szohar/TrueLocation_lay/TruelocationRev3.0/TruelocationRev3.0-by-mpn.xlsx

Reference | Value | Datasheet | Footprint | Description | Qty | MANUFACTURER | MANUFACTURER P/N | MFG_PN | DNP | CHANGED | STATUS | ALT. MFR. | ALT MFR. PART | ALT. REPLACEMENT COMMENT
ANT1 | SR4W035 | https://www.antenova.com/wp-content/uploads/2019/05/Serica-SR4W035-PS-1.1.pdf | Library:IC_ANT_W6.1L4.1H0.5_6PIN | RF ANT 2.4GHZ CHIP SOLDER SMD | 1 | ANTENOVA | SR4W035
C1,C8,C19,C20,C28,C30,C31,C34,C36,C38,C40,C41,C42,C45,C47,C48,C51,C52,C54,C56,C57,C58,C62,C63,C65,C67,C72,C74,C78,C79,C80,C81,C82,C83,C86,C87,C90,C91,C93,C94,C95,C96,C99,C104,C118,C119,C121,C124,C127,C132,C136,C138,C147,C153,C158,C167,C171,C173,C174,C177,C178,C180,C182,C185,C188,C209 | 0.1uF | https://mm.digikey.com/Volume0/opasdata/d220001/medias/docus/2715/CL05B104KO5NFNC_Spec.pdf | -- mixed values -- | CAP CER 0.1UF 16V X7R 0402 | 66 | SAMSUNG | CL05B104KO5NFNC |  |  | -- mixed values --
C2,C14 | 15pF | https://search.kemet.com/download/datasheet/C0402C150J4GAC7867 | Library:CAP_CHIP_0402_W24L44H24_RFL | CAP CER 15PF 16V C0G/NP0 0402 | 2 | KEMET | C0402C150J4GACTU
C3,C4,C25,C27,C32,C100,C101,C103,C105,C112,C114,C179,C186,C187 | 2.2uF | https://mm.digikey.com/Volume0/opasdata/d220001/medias/docus/387/LMK105BJ225MV-F_SS.pdf | Library:CAP_CHIP_0402_W24L44H24_RFL | CAP CER 2.2UF 10V X5R 0402 | 14 | TAIYO YUDEN | LMK105BJ225MV-F |  |  | -- mixed values --
C5 | 0.6pF | https://www.johansondielectrics.com/search/pdf/?s=%22QSCF500Q0R6A1GV001T%22 | Library:CAP_CHIP_0402_W24L44H24_RFL | CAP CER 0.6PF 50V C0G/NP0 0402 | 1 | JOHANSON TECHNOLOGY | QSCF500Q0R6A1GV001T |  |  | 1
C6,C11,C12,C15,C16,C22,C23,C24,C43,C44,C53,C59,C60,C68,C69,C70,C76,C77,C84,C85,C97,C98,C172 | 22pF | https://search.murata.co.jp/Ceramy/image/img/A01X/G101/ENG/GCM1555C1HR50BA16-01A.pdf | Library:CAP_CHIP_0402_W24L44H24_RFL | CAP CER 22PF 50V C0G/NP0 0402 | 23 | MURATA ELECTRONICS | GCM1555C1H220JA16D |  |  | -- mixed values --
C7,C13,C106 | NI | https://search.kemet.com/download/datasheet/C0603C220J5GAC7867 | Library:CAP_CHIP_0402_W24L44H24_RFL | CAP CER 22PF 50V C0G/NP0 0603 | 3 | AVX | C0603C220J5GACTU |  | DNP
C9,C18,C141,C142 | 10uF | https://search.murata.co.jp/Ceramy/image/img/A01X/G101/ENG/GRM188R61A106KE69-01.pdf | -- mixed values -- | CAP CER 10UF 10V X5R 0603 | 4 | MURATA ELECTRONICS | GRM188R61A106KE69J |  |  | 1 | NON STOCK | KYOCERA | 0603ZD106KAT2A | SUGGESTED DIRECT REPLACEMENT
C10 | 1.2pF | https://search.murata.co.jp/Ceramy/image/img/A01X/G101/ENG/GJM1555C1H1R2WB01-01.pdf | Library:CAP_CHIP_0402_W24L44H24_RFL | CAP CER 1.2PF 50V C0G/NP0 0402 | 1 | MURATA ELECTRONICS | GJM1555C1H1R2WB01D
C17 | 1.8nF | https://search.murata.co.jp/Ceramy/image/img/A01X/G101/ENG/GRM155R71H182JA01-01.pdf | Library:CAP_CHIP_0402_W24L44H24_RFL | CAP CER 1800PF 50V X7R 0402 | 1 | MURATA ELECTRONICS | GRM155R71H182JA01D |  |  | 1
C21,C29,C33,C123 | 1nF | https://search.kemet.com/download/datasheet/C0402C102K5RAC7867 | Library:CAP_CHIP_0402_W24L44H24_RFL | CAP CER 1000PF 50V X7R 0402 | 4 | KEMET | C0402C102K5RACTU |  |  | 1
C26,C35 | 4.7uF | https://search.murata.co.jp/Ceramy/image/img/A01X/G101/ENG/GRM188R61C475KE11-01.pdf | Library:CAP_CHIP_0603_W40L70H22_RFL | CAP CER 4.7UF 16V X5R 0603 | 2 | MURATA ELECTRONICS | GRM188R61C475KE11D |  |  | 1
C37,C39,C148,C161 | 10nF | https://www.yageo.com/upload/media/product/productsearch/datasheet/mlcc/UPY-GPHC_X7R_6.3V-to-250V_24.pdf | Library:CAP_CHIP_0402_W24L44H24_RFL | CAP CER 10000PF 50V X7R 0402 | 4 | YAGEO | CC0402KRX7R9BB103
C46,C64,C107,C108,C109,C110,C111,C113,C115,C116,C117,C120,C122,C125,C126,C129,C134,C146,C156 | 10pF | https://search.kemet.com/download/datasheet/C0402C100J3GAC7867 | Library:CAP_CHIP_0402_W24L44H24_RFL | CAP CER 10PF 25V C0G/NP0 0402 | 19 | KEMET | C0402C100J3GACTU |  |  | -- mixed values --
C49 | 47nF | https://www.yageo.com/upload/media/product/productsearch/datasheet/mlcc/UPY-GPHC_X7R_6.3V-to-250V_24.pdf | Library:CAP_CHIP_0402_W24L44H24_RFL | CAP CER 0.047UF 50V X7R 0402 | 1 | YAGEO | CC0402JRX7R9BB473
C50,C55,C89,C131 | 100pF | https://mm.digikey.com/Volume0/opasdata/d220001/medias/docus/609/CL05C101JB5NNNC_Spec.pdf | Library:CAP_CHIP_0402_W24L44H24_RFL | CAP CER 100PF 50V C0G/NP0 0402 | 4 | SAMSUNG | CL05C101JB5NNNC
C61,C152,C160 | 22uF | https://search.murata.co.jp/Ceramy/image/img/A01X/G101/ENG/GRM188R60J226MEA0-01.pdf | Library:CAP_CHIP_0603 | CAP CER 22UF 6.3V X5R 0603 | 3 | MURATA ELECTRONICS | GRM188R60J226MEA0J
C66,C166 | 2.2uF | https://www.yageo.com/upload/media/product/app/datasheet/mlcc/upy-gphc_x5r_4v-to-50v.pdf | Library:CAP_CHIP_0603 | CAP CER 2.2UF 10V X5R 0603 | 2 | YAGEO | CC0603KRX5R6BB225 |  |  | 1
C71 | 1nF |  | Library:CAP_CHIP_0402_W24L44H24_RFL | CAP CER 1000PF 16V X7R 0402 | 1 | YAGEO | CC0402KRX7R7BB102
C73 | 10uF | https://search.murata.co.jp/Ceramy/image/img/A01X/G101/ENG/GRJ155R60J106ME11-01.pdf | Library:CAP_CHIP_0402_W24L44H24_RFL | CAP CER 10UF 6.3V X5R 0402 | 1 | MURATA ELECTRONICS | GRJ155R60J106ME11D
C75,C137,C176,C184,FB3,FB5,FB10,J1,J2,J9,J10,J11,L1,L3,R3,R17,R18,R26,R27,R28,R32,R39,R45,R49,R53,R55,R56,R59,R67,R73,R78,R81,R91,R112,R113,R117,R123,R127,R129,R130,R140,R147,R151,R153,R156,R161,R165,R168,R172,R175,R184,R188,R190,R194,R200,R224,R225,TP1,TP2,TP3,TP4,TP5,TP6,TP7,TP8,TP9,TP10,TP11,TP12,TP13,TP14,TP15 | -- mixed values -- |  | -- mixed values -- |  | 72 |  | DoNotPurchase |  | DNP
C88,C92 | 220pF | https://www.passivecomponent.com/wp-content/uploads/datasheet/WTC_MLCC_General_Purpose.pdf | Library:CAP_CHIP_0402_W24L44H24_RFL | CAP CER 220PF 25V C0G/NP0 0402 | 2 | WALSIN | 0402N221J250CT
C102 | 2.2pF | https://www.yageo.com/en/Chart/Download/pdf/CC0402BRNPO9BN2R2 | Library:CAP_CHIP_0402_W24L44H24_RFL | CAP CER 2.2PF 50V C0G/NPO 0402 | 1 | YAGEO | CC0402BRNPO9BN2R2
C128,C181 | 4.7uF | https://search.murata.co.jp/Ceramy/image/img/A01X/G101/ENG/GRM155C80J475MEAA-01.pdf | Library:CAP_CHIP_0402_W24L44H24_RFL | CAP CER 4.7UF 6.3V X6S 0402 | 2 | MURATA ELECTRONICS | GRM155C80J475MEAAD |  |  | -- mixed values --
C130,C135 | 330pF | https://mm.digikey.com/Volume0/opasdata/d220001/medias/docus/536/UMK105CG331JVHF_SS.pdf | Library:CAP_CHIP_0402_W24L44H24_RFL | CAP CER 330PF 50V C0G/NP0 0402 | 2 | TAIYO | UMK105CG331JVHF
C133 | 0.68uF | https://www.yageo.com/upload/media/product/app/datasheet/mlcc/upy-gphc_x5r_4v-to-50v.pdf | Library:CAP_CHIP_0402_W24L44H24_RFL | CAP CER 0.68UF 10V X5R 0402 | 1 | YAGEO | CC0402KRX5R6BB684
C143,C145 | 2.7nF | https://search.murata.co.jp/Ceramy/image/img/A01X/G101/ENG/GRM155R71H272JA01-01.pdf | Library:CAP_CHIP_0402_W24L44H24_RFL | CAP CER 2700PF 50V X7R 0402 | 2 | MURATA | GRM155R71H272JA01D
C144,C150 | 360pF |  | Library:CAP_CHIP_0402_W24L44H24_RFL | CAP CER 360PF 50V CH 0402 | 2 | TAIYO | UMK105CH361JVHF |  |  |  | NRND
C149,C151 | 3nF | https://search.murata.co.jp/Ceramy/image/img/A01X/G101/ENG/GRM1557U1A302JA01-01A.pdf | Library:CAP_CHIP_0402_W24L44H24_RFL | CAP CER 3000PF 10V U2J 0402 | 2 | MURATA | GRM1557U1A302JA01D
C154,C157 | 2nF | https://datasheets.kyocera-avx.com/X7RDielectric.pdf | Library:CAP_CHIP_0402_W24L44H24_RFL | CAP CER 2000PF 50V X7R 0402 | 2 | AVX KYOCERA | 04025C202JAT2A
C155,C163 | 2.4nF | https://search.murata.co.jp/Ceramy/image/img/A01X/G101/ENG/GRM1557U1A242JA01-01A.pdf | Library:CAP_CHIP_0402_W24L44H24_RFL | CAP CER 2400PF 10V U2J 0402 | 2 | MURATA ELECTRONICS | GRM1557U1A242JA01D
C159 | 4.7pF | https://www.yageo.com/en/Chart/Download/pdf/CC0402BRNPO9BN4R7 | Library:CAP_CHIP_0402_W24L44H24_RFL | CAP CER 4.7PF 50V C0G/NPO 0402 | 1 | YAGEO | CC0402BRNPO9BN4R7
C162,C164 | 1.3nF |  | Library:CAP_CHIP_0402_W24L44H24_RFL | CAP CER MLCC | 2 | MURATA ELECTRONICS | GRM155R71H132JA01D |  |  |  | NON STOCK
C165 | 1uF | https://ds.yuden.co.jp/TYCOMPAS/ut/download?pn=MCASU105AB7683KFCA01&fileType=CS | Library:CAP_CHIP_0603 | CAP CER 1UF 10V X5R 0603 | 1 | TAIYO | LMK107BJ105MAHT |  |  | 1
C168 | 1pF | https://www.yageo.com/en/Chart/Download/pdf/CC0402BRNPO9BN1R0 | Library:CAP_CHIP_0402_W24L44H24_RFL | CAP CER 1PF 50V C0G/NPO 0402 | 1 | YAGEO | CC0402BRNPO9BN1R0
C169,C170 | 2.2nF | https://mm.digikey.com/Volume0/opasdata/d220001/medias/docus/2709/CL05B222JB5NNNC_Spec.pdf | Library:CAP_CHIP_0402_W24L44H24_RFL | CAP CER 2200PF 50V X7R 0402 | 2 | SAMSUNG | CL05B222JB5NNNC
C175 | 12pF | https://www.yageo.com/en/Chart/Download/pdf/CC0402JRNPO9BN120 | Library:CAP_CHIP_0402_W24L44H24_RFL | CAP CER 12PF 50V C0G/NPO 0402 | 1 | YAGEO | CC0402JRNPO9BN120
C183 | 1.2nF | https://www.yageo.com/upload/media/product/productsearch/datasheet/mlcc/UPY-GPHC_X7R_6.3V-to-250V_24.pdf | Library:CAP_CHIP_0402_W24L44H24_RFL | CAP CER 1200PF 50V X7R 0402 | 1 | YAGEO | CC0402JRX7R9BB122
D1 | PMEG3020CPASX | https://assets.nexperia.com/documents/data-sheet/PMEG3020CPAS.pdf | Library:DIODE_SOT1061D_3PIN | DIODE ARR SCHOT 30V 2A DFN2020D3 | 1 | NEXPERIA | PMEG3020CPASX
D2 | MADL-011021-14150T | https://cdn.macom.com/datasheets/MADL-011021-14150T.pdf | Library:IC_TDFN_0.4_W1.5L1.2H0.8_6PIN | RF DIODE PIN 6TDFN | 1 | MACOM | MADL-011021-14150T
D3,D4 | UHD1110-FKA | https://downloads.cree-led.com/files/ds/h/HB-UHD1110-FKA.pdf | Library:LED_CHIP_W1.15L1.15H0.61_4PIN | LED RGB 0404 SMD | 2 | CREE | UHD1110-FKA-CL1A13R3Q1BBQFMF3 |  | -- mixed values -- | 1 | OBSOLETE
D5 | Orange | https://www.rohm.com/datasheet?p=SML-P12DT(R)&dist=Digi-key&media=referral&campaign=Digi-key | Library:LED_CHIP_0402_W24L44H28 | LED ORANGE CLEAR 1006 SMD | 1 | ROHM | SML-P12DTT86R
D6 | RED | https://www.rohm.com/datasheet?p=SML-P12VT(R)&dist=Digi-key&media=referral&campaign=Digi-key | Library:LED_CHIP_0402_W24L44H28 | LED RED CLEAR 1006 SMD | 1 | ROHM | SML-P12VTT86R |  |  |  | NON STOCK
D7 | SBR3A40SAF | https://www.diodes.com/assets/Datasheets/SBR3A40SAF.pdf | Library:DIODE_DO-214AC | DIODE SBR 40V 3A SMAF | 1 | DIODES | SBR3A40SAF-13
D8 | BAV70M | https://assets.nexperia.com/documents/data-sheet/BAV70M.pdf | Library:DIODE_SOT883_3PIN | DIODE ARRAY GP 100V 150MA SOT883 | 1 | NEXPERIA | BAV70M,315
D9 | 1N4148WL2-TP | https://www.mccsemi.com/pdf/Products/1N4148WL2(DFN1006-2L).pdf | Library:DIODE_DFN1006 2PIN | DIODE STANDARD 100V 150MA 2DFN | 1 | MCC | 1N4148WL2-TP
D10 | PMEG2010BEA | https://assets.nexperia.com/documents/data-sheet/PMEG2010BEA.pdf | Library:DIODE_SOD-323 | DIODE SCHOTTKY 20V 1A SOD323 | 1 | NEXPERIA | PMEG2010BEA,115 |  | DNP
FB1,FB13 | 2A600Ohm | https://productfinder.pulseelectronics.com/api/open/part-attachments/datasheet/BBHV00160808601Y00 | -- mixed values -- | FERRITE BEAD 600 OHM 0603 1LN | 2 | PULSE ELECTRONICS | BBHV00160808601Y00
FB2,FB4,FB6,FB7,FB9,FB14 | 1K_0.35A | https://www.murata.com/en-us/products/productdata/8796740059166/ENFA0018.pdf | Library:CAP_CHIP_0402_W24L44H24_RFL | FERRITE BEAD 1 KOHM 0402 1LN | 6 | -- mixed values -- | BLM15AX102SN1D
FB8,FB11,FB12,FB15 | 3.8A | https://www.murata.com/en-us/products/productdata/8796740059166/ENFA0018.pdf | Library:CAP_CHIP_0402_W24L44H24_RFL | FERRITE BEAD 20 OHM 0402 1LN | 4 | MURATA ELECTRONICS | BLM15KD200SN1D
J3 | CONUFL001-SMD | https://www.te.com/commerce/DocumentDelivery/DDEController?Action=srchrtrv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 | Library:CON UFL 3PIN | CONN UMC JACK STR SMD | 1 | TE CONNECTIVITY | CONUFL001-SMD-T
J6 | MUSBR-B151-30 | https://cdn.amphenol-cs.com/media/wysiwyg/files/drawing/musbrb151xx.pdf | Library:D-TYPE_MUSBR_7PIN | CONN RCPT USB2.0 MINI B PCB R/A | 1 | AMPHENOL | MUSBR-B151-30 |  | DNP | 1
J12,J16 | 590 | https://www.keyelco.com/product-pdf.cfm?p=834 | Library:CON 628 3PIN | BATTERY CONTACT SPRING A PC PIN | 2 | KEYSTONE | 628
J13,J15 | 595 | https://www.keyelco.com/userAssets/file/M65p11.pdf | Library:CON 595 3PIN | BATTERY CONTACT SOLID A PC PIN | 2 | KEYSTONE | 595
J14 | 10118192-0002LF | https://cdn.amphenol-cs.com/media/wysiwyg/files/documentation/datasheet/inputoutput/io_usb_micro.pdf | Library:USB_ZX62-AB-5PA_5PIN | CONN RCPT USB2.0 MICRO B SMD R/A | 1 | AMPHENOL | 10118192-0002LF
J17 | BM28B0.6-30DS/2-0.35V | https://www.hirose.com/product/download/?distributor=digi&type=catalogue&lang=en&series=BM28 | Library:CON_BM28B0.6_HRS_30PIN | CONN RCPT 30POS SMD GOLD | 1 | HIROSE | BM28B0.6-30DS/2-0.35V
L2 | 5.6nH | https://search.murata.co.jp/Ceramy/image/img/P02/JELF243B-0009.pdf | Library:CAP_CHIP_0402 | FIXED IND 5.6NH 600MA 0.18OHM SM | 1 | MURATA ELECTRONICS | LQG15HN5N6S02D
L4 | 1.5uH | https://www.bourns.com/docs/Product-Datasheets/SRN4018TA.pdf | Library:COIL_MOLD_W4.2L4.2H1.88_2PIN | FIXED IND 1.5UH 2.7A 32 MOHM SMD | 1 | BOURNS | SRN4018TA-1R5M
L5,L6 | 15uH | https://product.tdk.com/en/system/files | Library:CAP_CHIP_0603 | FIXED IND 15UH 2MA 1.5 OHM SMD | 2 | TDK | MLF1608C150KTA00 |  |  | 1
L7,L8 | 8.2uH | https://www.waldom.com/upload/parts/datasheets/mf-abr/abr-aiml-0603-8r2k-t.pdf | Library:CAP_CHIP_0603_W40L70H22_RFL | FIXED IND 8.2UH 4MA 2.1 OHM SMD | 2 | ABRACON | AIML-0603-8R2K-T |  |  | 1
L9,L10 | 10uH | https://www.waldom.com/upload/parts/datasheets/mf-abr/abr-aiml-0603-100k-t.pdf | Library:CAP_CHIP_0603_W40L70H22_RFL | FIXED IND 10UH 3MA 2.55 OHM SMD | 2 | ABRACON | AIML-0603-100K-T |  |  | 1
Q1 | FDG312P | https://www.onsemi.com/pdf/datasheet/fdg312p-d.pdf | Library:IC_DCK_W2.15L1.40H1.10_6PIN | MOSFET P-CH 20V 1.2A SC88 | 1 | ONSEMI | FDG312P |  |  |  | OBSOLETE
Q2 | FZT948 | https://www.diodes.com/assets/Datasheets/FZT948.pdf | Library:IC_SOT-223_4PIN | TRANS PNP 20V 6A SOT-223-3 | 1 | DIODES | FZT948TA
Q3 | SSM3K15ACTC | https://toshiba.semicon-storage.com/info/docget.jsp?did=52901&prodName=SSM3K15ACTC | Library:TRANS_C3T3C_0.8X0.6 3PIN | MOSFET N-CH 30V 100MA CST3C | 1 | TOSHIBA | SSM3K15ACTC,L3F |  | DNP | 1
R1,R85,R100,R137,R138,R144,R186,R192,R226 | 22.1K | https://www.seielect.com/catalog/sei-rmcf_rmcp.pdf | Library:CAP_CHIP_0402_W24L44H24_RFL | RES 22.1K OHM 1% 1/16W 0402 | 9 | STACKPOLE | RMCF0402FT22K1
R2,R5,R6,R7,R8,R9,R10,R12,R14,R15,R16,R34,R43,R61,R62,R64,R69,R70,R71,R99,R101,R103,R104,R105,R106,R118,R121,R122,R125,R131,R133,R139,R142,R146,R150,R166,R173,R191,R199,R201,R212 | 1K | https://www.yageo.com/upload/media/product/products/datasheet/rchip/PYu-RC_Group_51_RoHS_L_12.pdf | Library:CAP_CHIP_0402_W24L44H24_RFL | RES 1K OHM 1% 1/16W 0402 | 41 | YAGEO | RC0402FR-071KL
R4,R20,R24,R29,R31,R35,R36,R37,R38,R40,R42,R46,R47,R48,R52,R57,R58,R60,R63,R68,R72,R79,R92,R93,R94,R95,R96,R97,R98,R102,R110,R111,R114,R115,R116,R126,R134,R135,R136,R141,R143,R152,R154,R155,R159,R176,R179,R181,R182,R189,R197,R198,R202,R205,R206,R207,R208,R209,R210,R211 | 0 | https://www.te.com/commerce/DocumentDelivery/DDEController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 | Library:CAP_CHIP_0402_W24L44H24_RFL | RES SMD 0 OHM JUMPER 1/16W 0402 | 60 | TE CONNECTIVITY | CRG0402ZR |  | -- mixed values --
R11,R13,R82,R120,R174,R177,R227,R228 | 100 | https://www.seielect.com/catalog/sei-rmcf_rmcp.pdf | Library:CAP_CHIP_0402_W24L44H24_RFL | RES 100 OHM 1% 1/16W 0402 | 8 | STACKPOLE | RMCF0402FT100R
R19,R25,R77,R80 | 4.7K | https://www.seielect.com/catalog/sei-rmcf_rmcp.pdf | Library:CAP_CHIP_0402_W24L44H24_RFL | RES 4.7K OHM 1% 1/16W 0402 | 4 | STACKPOLE | RMCF0402FT4K70
R21 | 2.7K | https://www.seielect.com/catalog/sei-rmcf_rmcp.pdf | Library:CAP_CHIP_0402_W24L44H24_RFL | RES 2.7K OHM 1% 1/16W 0402 | 1 | STACKPOLE | RMCF0402FT2K70
R22,R160 | 100K | https://www.seielect.com/catalog/sei-rmcf_rmcp.pdf | Library:CAP_CHIP_0402_W24L44H24_RFL | RES 100K OHM 1% 1/16W 0402 | 2 | STACKPOLE | RMCF0402FT100K
R23,R119 | 680 | https://www.yageo.com/upload/media/product/products/datasheet/rchip/PYu-RC_Group_51_RoHS_L_12.pdf | Library:CAP_CHIP_0402_W24L44H24_RFL | RES 680 OHM 1% 1/16W 0402 | 2 | YAGEO | RC0402FR-07680RL |  |  |  | NON STOCK
R30,R66,R89 | 200 | https://www.yageo.com/upload/media/product/products/datasheet/rchip/PYu-RC_Group_51_RoHS_L_12.pdf | Library:CAP_CHIP_0402_W24L44H24_RFL | RES 200 OHM 1% 1/16W 0402 | 3 | YAGEO | RC0402FR-07200RL
R33,R41,R44,R54,R124,R132,R178,R183,R195,R204 | 10K | https://www.seielect.com/catalog/sei-rmcf_rmcp.pdf | Library:CAP_CHIP_0402_W24L44H24_RFL | RES 10K OHM 1% 1/16W 0402 | 10 | STACKPOLE | RMCF0402FT10K0
R50,R157 | 40.2 | https://www.seielect.com/catalog/sei-rmcf_rmcp.pdf | Library:CAP_CHIP_0402_W24L44H24_RFL | RES 40.2 OHM 1% 1/16W 0402 | 2 | STACKPOLE | RMCF0402FT40R2
R51 | 174 | https://www.yageo.com/upload/media/product/products/datasheet/rchip/PYu-RC_Group_51_RoHS_L_12.pdf | Library:CAP_CHIP_0402_W24L44H24_RFL | RES 174 OHM 1% 1/16W 0402 | 1 | YAGEO | RC0402FR-07174RL
R65,R83,R90,R145,R193 | 49.9 | https://www.yageo.com/upload/media/product/products/datasheet/rchip/PYu-RC_Group_51_RoHS_L_12.pdf | Library:CAP_CHIP_0402_W24L44H24_RFL | RES 49.9 OHM 1% 1/16W 0402 | 5 | YAGEO | RC0402FR-0749R9L
R74,R84 | 21 | https://www.yageo.com/upload/media/product/products/datasheet/rchip/PYu-RC_Group_51_RoHS_L_12.pdf | Library:CAP_CHIP_0402_W24L44H24_RFL | RES 21 OHM 1% 1/16W 0402 | 2 | YAGEO | RC0402FR-0721RL
R75,R76,R86,R87,R88 | 330K | https://www.yageo.com/upload/media/product/products/datasheet/rchip/PYu-RC_Group_51_RoHS_L_12.pdf | Library:CAP_CHIP_0402_W24L44H24_RFL | RES 330K OHM 5% 1/16W 0402 | 5 | YAGEO | RC0402JR-07330KL
R107,R109 | 21.5 | https://www.yageo.com/upload/media/product/products/datasheet/rchip/PYu-RC_Group_51_RoHS_L_12.pdf | Library:CAP_CHIP_0402_W24L44H24_RFL | RES 21.5 OHM 1% 1/16W 0402 | 2 | YAGEO | RC0402FR-0721R5L
R108 | 46.4 | https://www.yageo.com/upload/media/product/products/datasheet/rchip/PYu-RC_Group_51_RoHS_L_12.pdf | Library:CAP_CHIP_0402_W24L44H24_RFL | RES 46.4 OHM 1% 1/16W 0402 | 1 | YAGEO | RC0402FR-0746R4L
R128 | 2K | https://www.seielect.com/catalog/sei-rmcf_rmcp.pdf | Library:CAP_CHIP_0402_W24L44H24_RFL | RES 2K OHM 1% 1/16W 0402 | 1 | STACKPOLE | RMCF0402FT2K00
R148 | 2M | https://www.seielect.com/catalog/sei-rmcf_rmcp.pdf | Library:CAP_CHIP_0402_W24L44H24_RFL | RES 2M OHM 1% 1/16W 0402 | 1 | STACKPOLE | RMCF0402FT2M00
R149 | 4.12M | https://www.vishay.com/docs/20035/dcrcwe3.pdf | Library:CAP_CHIP_0402_W24L44H24_RFL | RES SMD 4.12M OHM 1% 1/16W 0402 | 1 | VISHAY | CRCW04024M12FKED
R158,R164,R229,R230 | 1.1M | https://www.seielect.com/catalog/sei-rmcf_rmcp.pdf | Library:CAP_CHIP_0402_W24L44H24_RFL | RES 1.1M OHM 1% 1/16W 0402 | 4 | STACKPOLE | RMCF0402FT1M10
R162 | 180K | https://www.yageo.com/upload/media/product/products/datasheet/rchip/PYu-RC_Group_51_RoHS_L_12.pdf | Library:CAP_CHIP_0402_W24L44H24_RFL | RES 180K OHM 5% 1/16W 0402 | 1 | YAGEO | RC0402JR-07180KL
R163 | 68K | https://www.yageo.com/upload/media/product/products/datasheet/rchip/PYu-RC_Group_51_RoHS_L_12.pdf | Library:CAP_CHIP_0402_W24L44H24_RFL | RES 68K OHM 5% 1/16W 0402 | 1 | YAGEO | RC0402JR-0768KL
R167,R169,R180,R185,R196,R203 | 20 | https://www.seielect.com/catalog/sei-rmcf_rmcp.pdf | Library:CAP_CHIP_0402_W24L44H24_RFL | RES 20 OHM 5% 1/16W 0402 | 6 | STACKPOLE | RMCF0402JT20R0
R170,R171 | 330 | https://www.yageo.com/upload/media/product/products/datasheet/rchip/PYu-RC_Group_51_RoHS_L_12.pdf | Library:CAP_CHIP_0402_W24L44H24_RFL | RES 330 OHM 5% 1/16W 0402 | 2 | YAGEO | RC0402JR-07330RL
R187 | 8.2k | https://www.yageo.com/upload/media/product/products/datasheet/rchip/PYu-RC_Group_51_RoHS_L_12.pdf | Library:CAP_CHIP_0402_W24L44H24_RFL | RES 8.2K OHM 1% 1/16W 0402 | 1 | YAGEO | RC0402FR-078K2L |  |  |  | NON STOCK
SW1 | PTS820J20 | https://www.ckswitches.com/media/1474/pts820.pdf | Library:SWITCH_W3.9L2.9H2.5_6PIN | SWITCH TACTILE SPST-NO 0.05A 12V | 1 | C&K | PTS820J20MPSMTRLFS |  |  |  | NON STOCK
SW2 | PTS820J15 | https://www.ckswitches.com/media/1474/pts820.pdf | Library:SWITCH_W3.9L2.9H2.5_6PIN | SWITCH TACTILE SPST-NO 0.05A 12V | 1 | C&K | PTS820J15KPSMTRLFS
T1 | 2450BL15B100 | https://www.johansontechnology.com/docs/2069/2450BL15B100_Mse0zU1.pdf | Library:COIL_MOLD_2.1x1.35_6PIN | BALUN 2.4GHZ-2.5GHZ 50/100 0805 | 1 | JOHANSON | 2450BL15B100 |  |  |  | NON STOCK
T2 | 2450BL15B050 | https://www.johansontechnology.com/datasheets/2450BL15B050/2450BL15B050.pdf | Library:COIL_MOLD_2.1x1.35_6PIN | BALUN 2.4GHZ-2.5GHZ 50/50 0805 | 1 | JOHANSON | 2450BL15B050
T3 | ACM2012D-900-2P-T00 | https://mm.digikey.com/Volume0/opasdata/d220001/medias/docus/4129/ACM2012D_Series.pdf | Library:ACM2012D W2.2L1.4H1.3_4PIN | CMC 300MA 2LN 90 OHM SMD | 1 | TDK | ACM2012D-900-2P-T00
U1 | TCK111G | https://toshiba.semicon-storage.com/info/TCK111G_datasheet_en_20241029.pdf?did=147341&prodName=TCK111G | Library:IC_0.5_W1L1.5H0.54_6PIN | IC PWR SWITCH N-CHAN 1:1 6WCSP | 1 | TOSHIBA | TCK111G,LF
U2 | 74LVC244ABQ | https://assets.nexperia.com/documents/data-sheet/74LVC_LVCH244A.pdf | Library:IC_QFN_W4.6L2.6H1_21PIN | IC BUFF NON-INVERT 3.6V 20DHVQFN | 1 | NEXPERIA | 74LVC244ABQ,115
U3,U6 | 2450BP08A0100 | https://www.johansontechnology.com/datasheets/2450BP08A0100/2450BP08A0100.pdf | Library:COIL_MOLD_1.55x1.25_5PIN | RF FILTER BAND PASS 2.45GHZ 5SMD | 2 | JOHANSON | 2450BP08A0100
U4 | AT86RF233-ZUR | https://ww1.microchip.com/downloads/en/DeviceDoc/Atmel-8351-MCU_Wireless-AT86RF233_Datasheet.pdf | Library:IC_QFN_0.5_W5.1L5.1H0.9_32PIN_KO | IC RF TXRX+MCU 802.15.4 32QFN | 1 | MICROCHIP | AT86RF233-ZUR
U5 | MAX40203AUK+T | https://www.analog.com/media/en/technical-documentation/data-sheets/max40203.pdf | Library:IC_SOT-23_5OF6PIN | IC IDEAL DIODE | 1 | ANALOG DEVICES | MAX40203AUK+T
U7 | BMP-280 | https://www.bosch-sensortec.com/media/boschsensortec/downloads/datasheets/bst-bmp280-ds001.pdf | Library:IC_0.65_W2.6L2.1H1.1_8PIN | SENSOR 15.95PSIA 16BIT 8SMD | 1 | BOSCH | BMP-280 |  |  |  | OBSOLETE
U8 | SKY6611211 | https://www.skyworksinc.com/-/media/4C7B484628BA46BDADCB2E2AACDFA1ED.pdf | Library:IC_QFN_W3L3.5H1.1_23PIN | CONNECTED HOME/WEARABLEBLE+ZIGBE | 1 | SKYWORKS | SKY66112-11
U9 | 2450BP07A0100T | https://www.johansontechnology.com/datasheets/2450BP07A0100/2450BP07A0100.pdf | Library:COIL W1.0L0.5H0.38_3PIN | RF FILTER BAND PASS 2.45GHZ 0402 | 1 | JOHANSON | 2450BP07A0100001T
U10 | LTC4060EDHC | https://www.analog.com/media/en/technical-documentation/data-sheets/4060f.pdf | Library:IC_MLF_0.5_W3L5H1.0_16PIN | IC BAT CHG MULT-CHEM 1-4CL 16DFN | 1 | ANALOG DEVICES | LTC4060EDHC
U11 | BGS13S4N9 | https://www.infineon.com/dgdl/Infineon-BGS13S4N9-DS-v01_00-EN.pdf?fileId=5546d46262475fbe016248809d333d02 | Library:IC_BGA_0.4_W1.1L1.1H0.4_9PIN | IC RF SWITCH SP3T 3GHZ TSNP9-3 | 1 | INFINEON | BGS13S4N9E6327XTSA1 |  |  |  | OBSOLETE
U12,U17 | 74AUP2G32RA3-7 | https://www.diodes.com/assets/Datasheets/74AUP2G32.pdf | Library:DIODE_W1.25L1.05H0.35_8PIN | IC GATE OR 2CH 2-INP DFN1210-8 | 2 | DIODES | 74AUP2G32RA3-7 |  |  |  | NON STOCK | NEXPERIA | 74AUP2G32GS,115
U13 | AD8347 | https://www.analog.com/media/en/technical-documentation/data-sheets/AD8347.pdf | Library:IC_SO_0.65_W4.4L9.7H1.2_28PIN | RF DEMOD IC 800MZ-2.7GHZ 28TSSOP | 1 | ANALOG DEVICES | AD8347ARUZ
U14 | 74LVC1G04FW5-7 | https://www.diodes.com/assets/Datasheets/74LVC1G04.pdf | Library:DIODE_W1.050L1.050H0.50_6PIN | IC INVERTER 1CH 1-INP DFN1010-6 | 1 | DIODES | 74LVC1G04FW5-7 |  |  |  | NON STOCK | NEXPERIA | 74LVC1G04GM,132
U15,U18 | BGS12SN6 | https://www.infineon.com/dgdl/Infineon-BGS12SN6-DS-v01_02-en.pdf?fileId=db3a30433f1b26e8013f2db58bc03856 | Library:IC_BGA_0.4_W0.7L1.1H0.4_6PIN | IC RF SWITCH SPDT 6GHZ TSNP6-2 | 2 | INFINEON | BGS12SN6E6327XTSA1 |  |  |  | OBSOLETE | INFINEON | BGS12WN6E6327XTSA1 | SUGGESTED BY MFR, DIFFERENT IC PACKAGE MAY NEED PCB REVIEW
U16 | KXTJ3-1057 | https://fscdn.rohm.com/kionix/en/datasheet/kxtj3-1057-e.pdf | Library:IC_QFN_0.5W2.05L2.05H1_12PIN | ACCELEROMETER 2-16G I2C 12LGA | 1 | KIONIX | KXTJ3-1057
U19 | BC847QAPNZ | https://assets.nexperia.com/documents/data-sheet/BC847QAPN.pdf | Library:IC_0.35_W1.15L1.05H0.40_8PIN | TRANS NPN/PNP 45V 0.1A DFN1010B | 1 | NEXPERIA | BC847QAPNZ
U20 | HHM2293A1 | https://product.tdk.com/info/en/documents/data_sheet/rf_coupler_hhm2293a1_en.pdf?ref_disty=digikey | Library:IC_0.55_W1.7L0.90H0.7_6PIN | RF POWER DVDR 2.4GHZ-2.5GHZ 0603 | 1 | TDK | HHM2293A1
U21 | MAX2750AUA | https://www.analog.com/media/en/technical-documentation/data-sheets/MAX2750AUA.pdf | Library:IC SO 0.65 3.1X3.1 8PIN | IC VCO MONO 2.4GHZ 8-MSOP | 1 | ANALOG DEVICES | MAX2750AUA+
U22 | TCK106AG | https://toshiba.semicon-storage.com/info/docget.jsp?did=30131&prodName=TCK106AG | Library:IC_0.4_W0.79L0.79H0.59_4PIN | IC PWR SWITCH P-CHAN 1:1 4WCSPD | 1 | TOSHIBA | TCK106AG,LF
U23 | LMX2491 | https://www.ti.com/general/docs/suppproductinfo.tsp?distId=10 | Library:IC_QFN_0.5_W4.1L4.1H0.8_25PIN | IC FREQ SYNTH 24WQFN | 1 | TI | LMX2491RTWR
U24 | SKY65971-11 | https://www.skyworksinc.com/-/media/0D637E0CF85D4A29A58FC4533B508C39.pdf | Library:IC_QFN_W1.5L1.5H0.50_6PIN | IC AMP 802.11B/G/N 2-2.5GHZ 6QFN | 1 | SKYWORKS | SKY65971-11
U25,U26,U35 | NCP167BMX330TBG | https://www.onsemi.com/pdf/datasheet/ncp167-d.pdf | Library:IC _DFN_W1L 1H0.43_ 5PIN | IC REG LINEAR 3.3V 700MA 4-XDFN | 3 | ONSEMI | NCP167BMX330TBG
U27,U29 | SN74LVC1G3157DCKR | https://mm.digikey.com/Volume0/opasdata/d220001/medias/docus/5063/SN74LVC1G3157DCKR.pdf | Library:IC_DCK_W2.15L1.40H1.10_6PIN | IC SW SPDT-NO/NCX1 7OHM SC70-6 | 2 | UMW | SN74LVC1G3157DCKR
U28 | LM321LV | https://www.ti.com/general/docs/suppproductinfo.tsp?distId=10 | Library:IC_SC70-6_5OF6PIN | IC OPAMP GP 1 CIRCUIT SC70-5 | 1 | TI | LM321LVIDCKR
U30,U31 | ESDA6V1BC6_3 | https://www.st.com/content/ccc/resource/technical/document/datasheet/21/07/21/e3/a8/df/42/a2/CD00001906.pdf/files/CD00001906.pdf/jcr:content/translations/en.C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 | Library:IC_SOT-23_6PIN | TVS DIODE 5VWM SOT23-6 | 2 | ST | ESDA6V1BC6 |  | -- mixed values -- | -- mixed values --
U32 | STM32H753VIT6 | https://www.st.com/resource/en/datasheet/stm32h743bi.pdf | Library:IC_QUAD_0.5_W14L14H1.6_100PIN | IC MCU 32BIT 2MB FLASH 100LQFP | 1 | ST | STM32H743VIT6
U33 | TPS63020DSJR | https://www.ti.com/general/docs/suppproductinfo.tsp?distId=10 | Library:IC_QFN_W4.15L3.15H1_15PIN | IC REG BUCK BST ADJ 3.5A 14VSON | 1 | TI | TPS63020DSJR
U34 | LMK1C1102PW | https://www.ti.com/lit/ds/symlink/lmk1c1102.pdf | Library:IC_SO_0.65_W4.4L3.0H1.2_8PIN | IC CLK BUFFER 1:2 250MHZ 8TSSOP | 1 | TI | LMK1C1102PWR
X1 | 32.768KHz | https://support.epson.biz/td/api/doc_check.php?dl=brief_FC-135&lang=en | Library:XTAL_CHIP_W3.3L1.6H0.9_2PIN | CRYSTAL 32.7680KHZ 7PF SMD | 1 | EPSON | FC-135 32.7680KA-AG5
Y1 | XTL_16MHZ_3X2 | https://support.epson.biz/td/api/doc_check.php?dl=brief_TSX-3225&lang=en | Library:XTAL_CHIP_W3.35L2.65H20.6_4PIN | CRYSTAL 16.0000MHZ 9PF SMD | 1 | EPSON | TSX-3225 16.0000MF09Z-AC0
Y2 | TCXO_20.0_FOX924B | https://abracon.com/datasheets/Fox/FT5HN.pdf | Library:XTAL_CHIP_W5.2L7.2H2_4PIN | XTAL OSC TCXO 20.0000MHZ HCMOS | 1 | FOX ELECTRONICS | FOX924B-20.000 |  |  | 1 | OBSOLETE | FOX ELECTRONICS | FT5HNBPK20.0-T1 | PART PARAMETRICS THE SAME AS ORIGINAL PART#CHANGE BY PCN#101536 (REF https://www.mouser.com/PCN/Fox_PN_101536___Standard_Part_Number_Change_(002).pdf)
