szohar/TrueLocation_lay/TruelocationRev3.0/TL_MCU.kicad_sch

## KiCad design TruelocationRev3.0/TL_MCU.kicad_sch (2025-07-09)

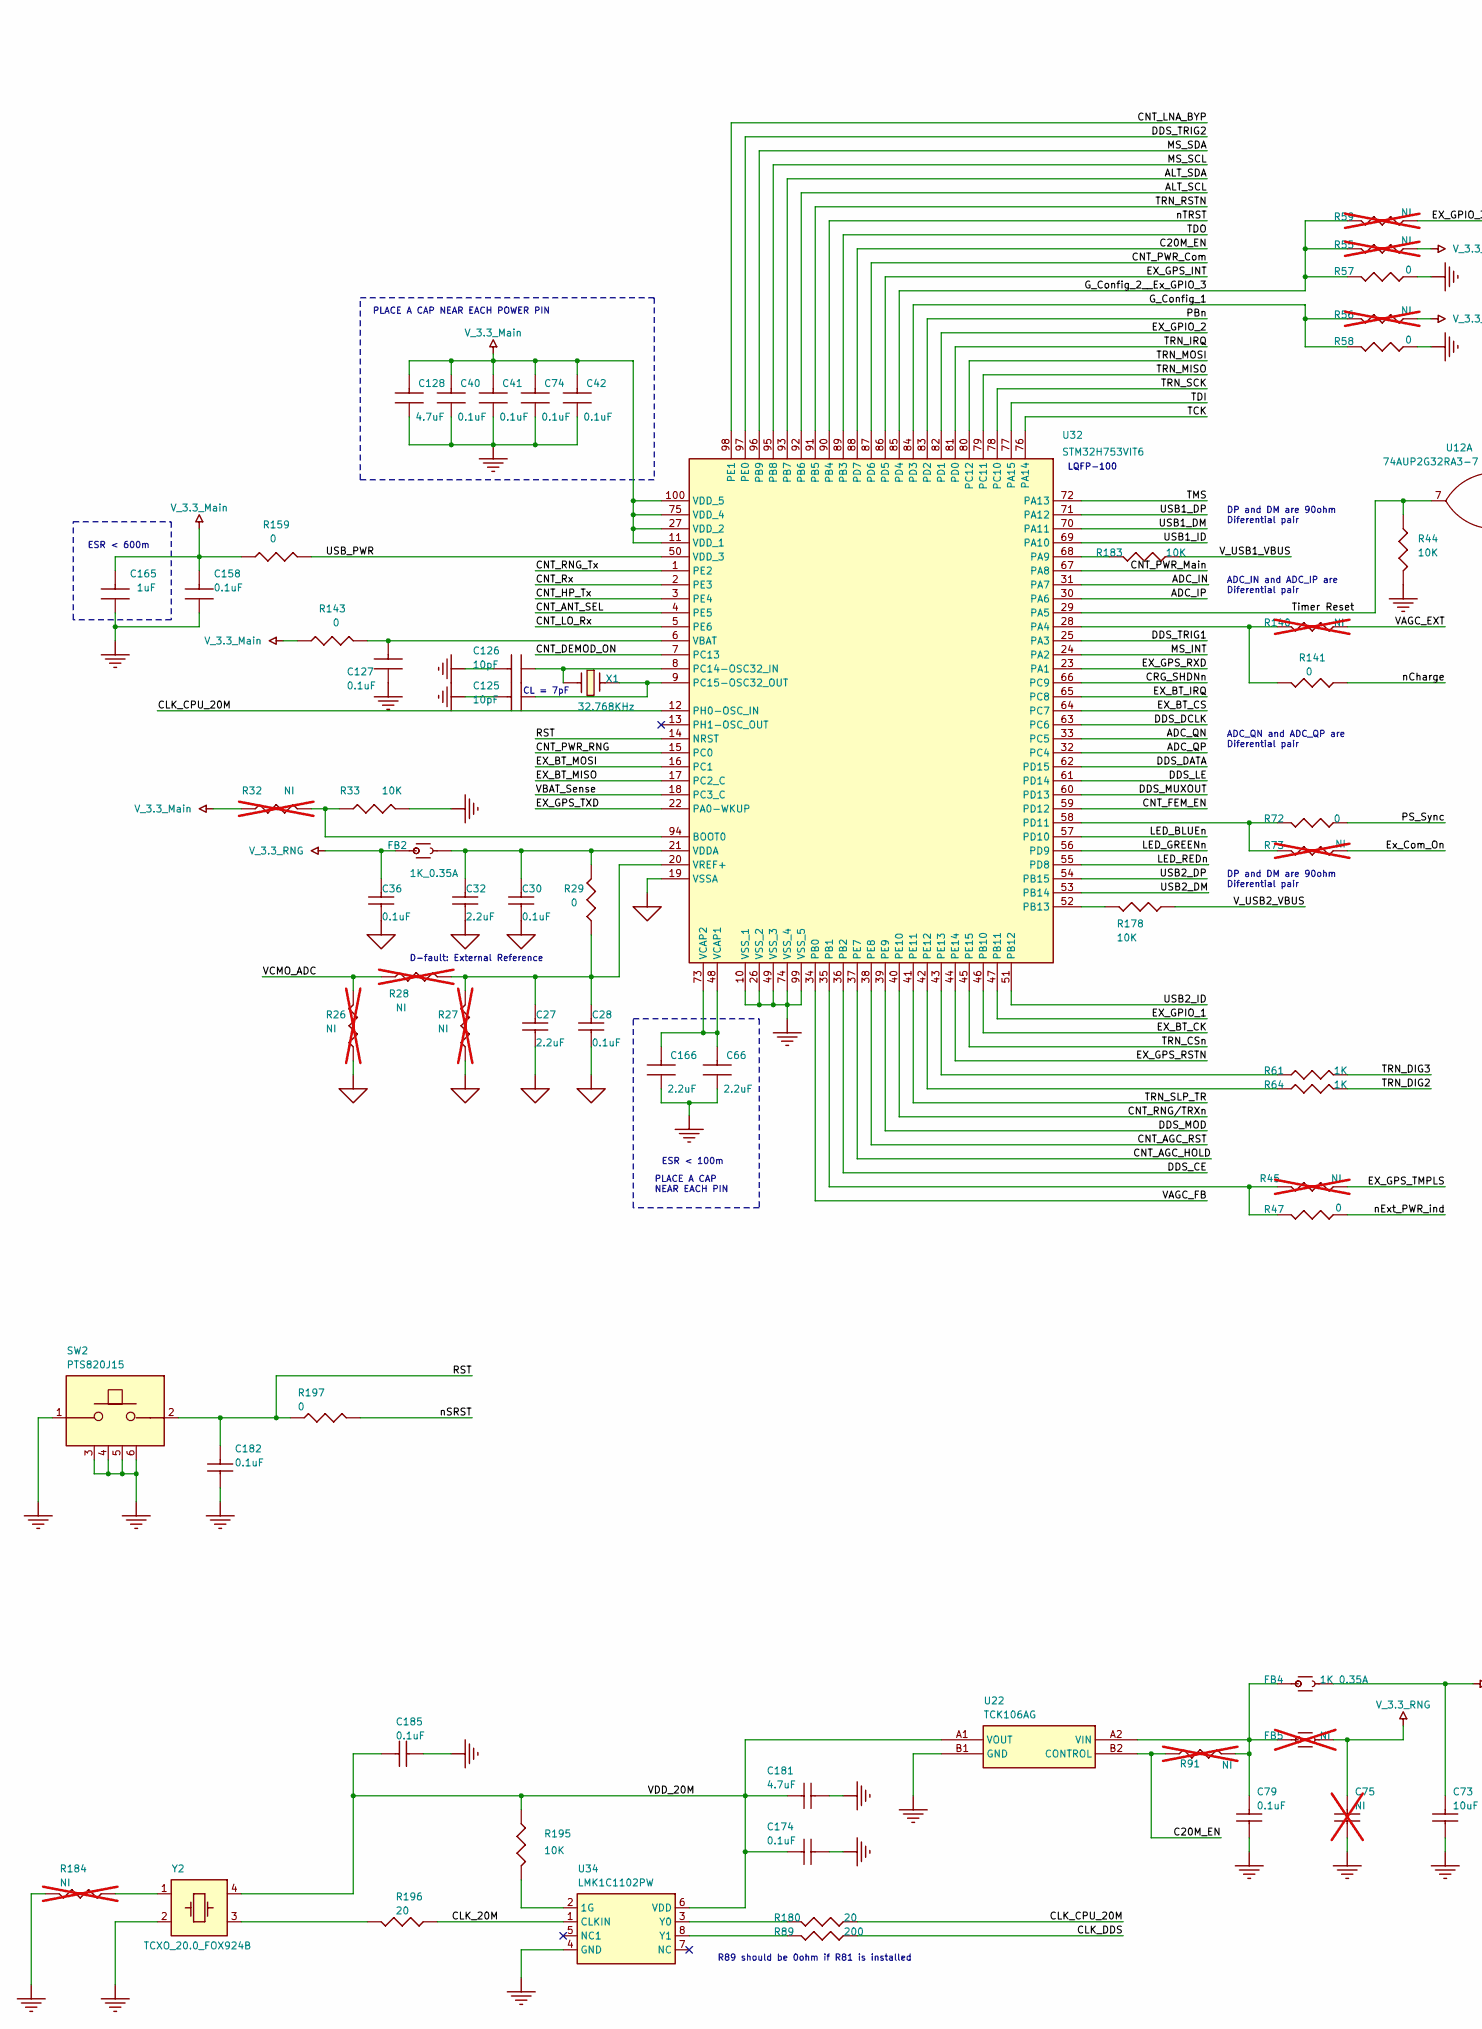
[picture p1: schematic TL_MCU.kicad_sch, part in row 1, column 1]

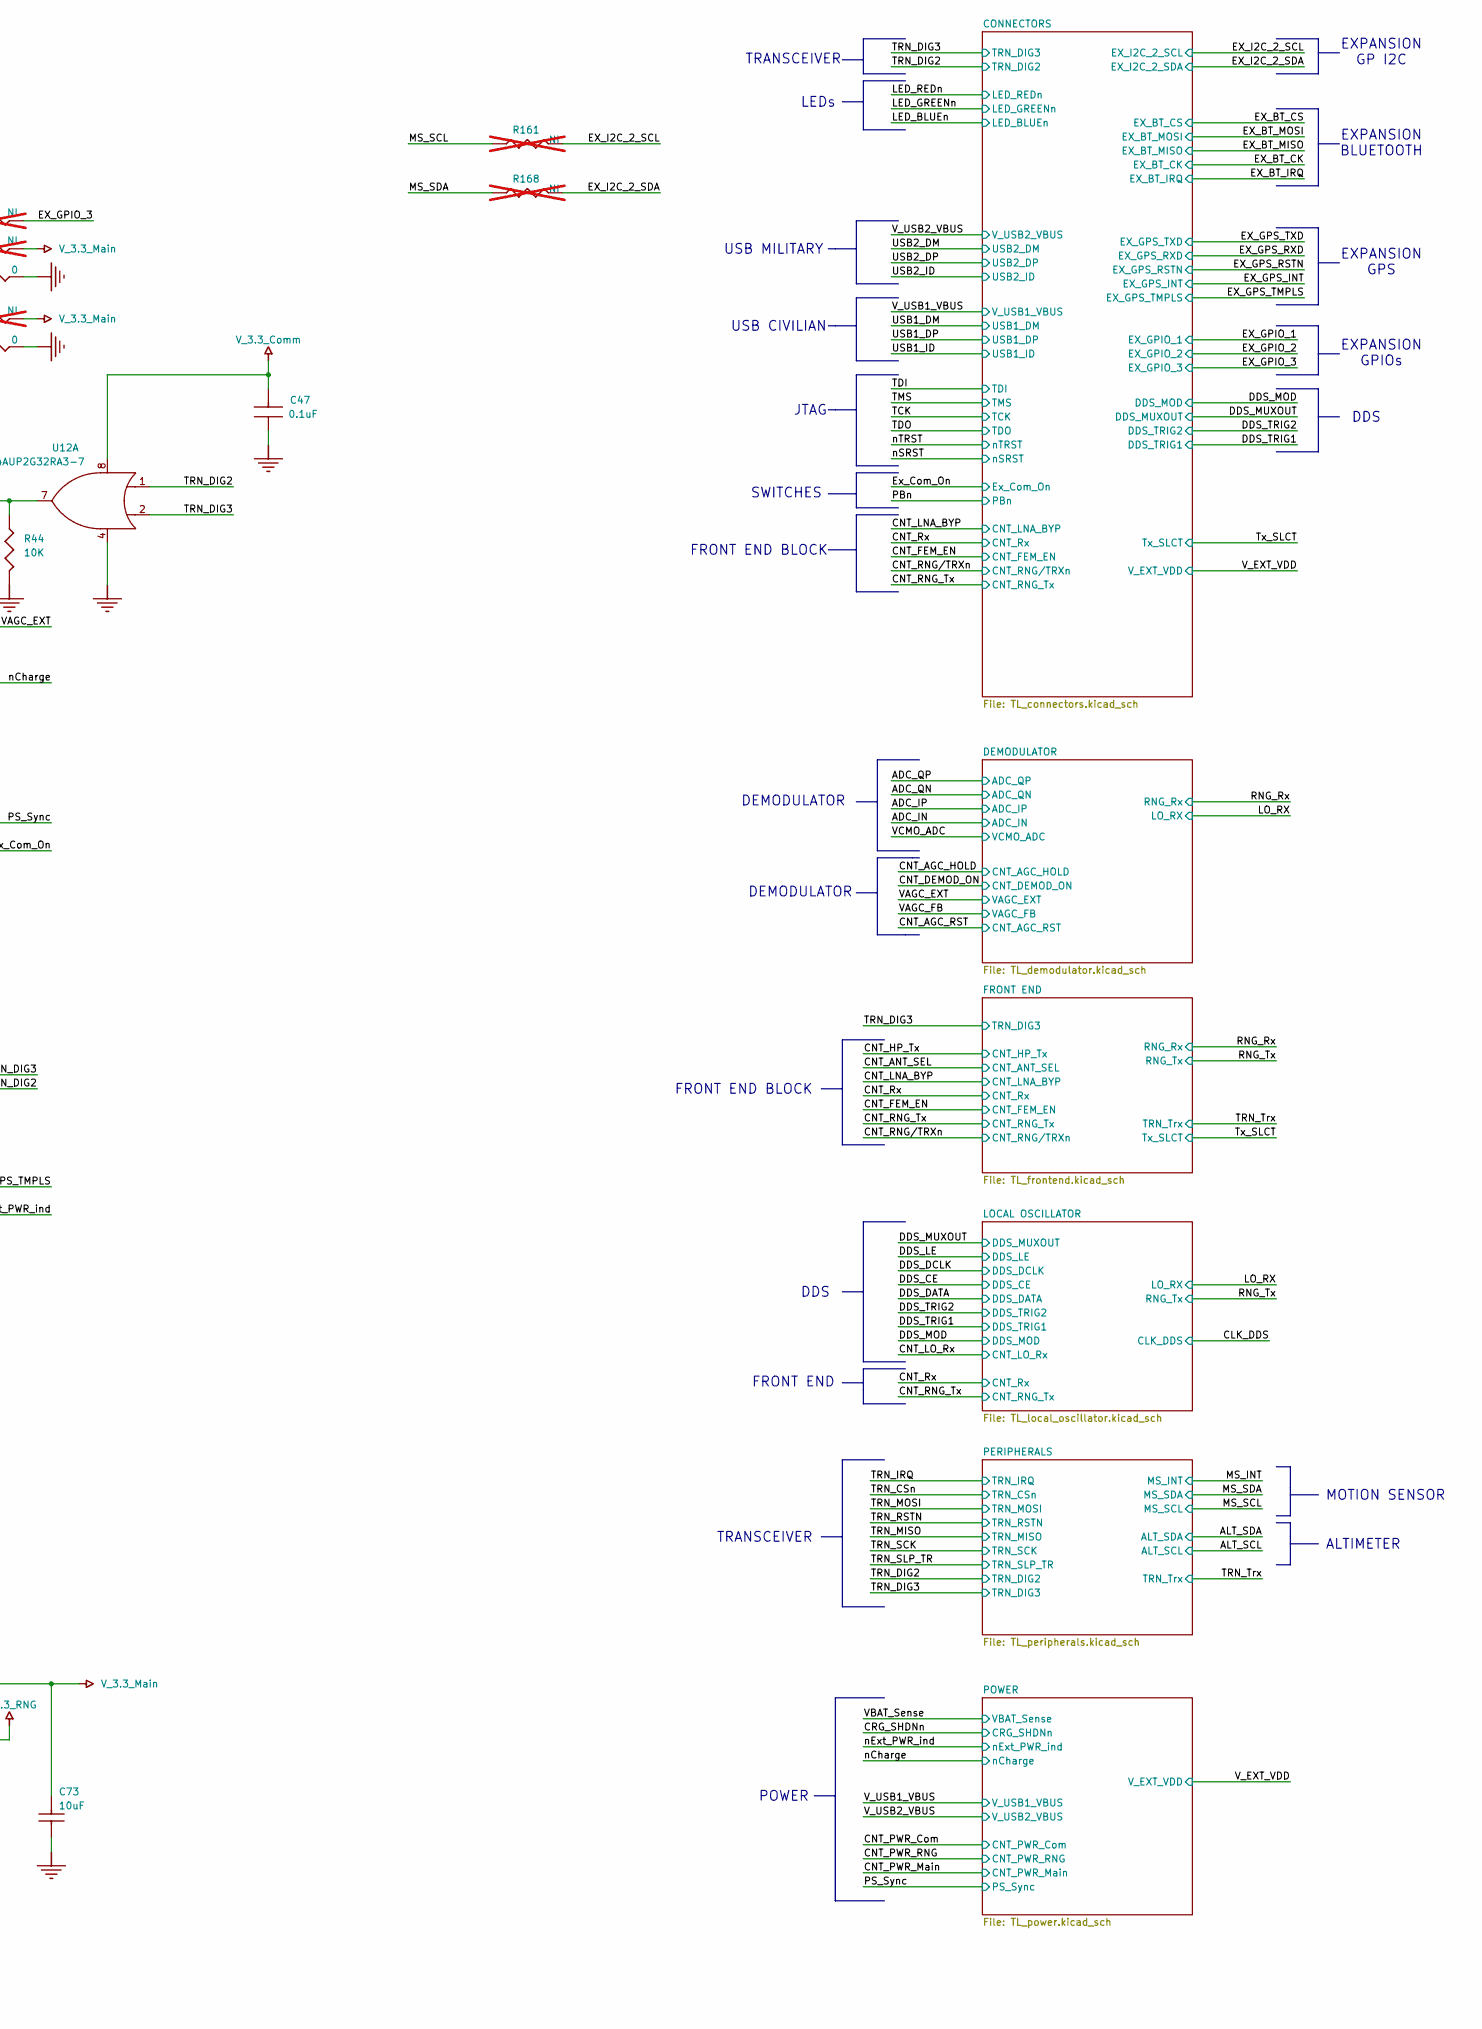
[picture p2: schematic TL_MCU.kicad_sch, part in row 1, column 2]

Parts:
C27, C32: 2.2uF; CAP_CHIP_0402_W24L44H24_RFL; MANUFACTURER P/N LMK105BJ225MV-F
C28, C30, C36, C40, C41, C42, C47, C74, C79, C127, C158, C174, C182, C185: 0.1uF; CAP_CHIP_0402_W24L44H24_RFL; MANUFACTURER P/N CL05B104KO5NFNC
C66, C166: 2.2uF; CAP_CHIP_0603; MANUFACTURER P/N CC0603KRX5R6BB225
C73: 10uF; CAP_CHIP_0402_W24L44H24_RFL; MANUFACTURER P/N GRJ155R60J106ME11D
C75: NI; CAP_CHIP_0402_W24L44H24_RFL; MANUFACTURER P/N DoNotPurchase; not fitted
C125, C126: 10pF; CAP_CHIP_0402_W24L44H24_RFL; MANUFACTURER P/N C0402C100J3GACTU
C128, C181: 4.7uF; CAP_CHIP_0402_W24L44H24_RFL; MANUFACTURER P/N GRM155C80J475MEAAD
C165: 1uF; CAP_CHIP_0603; MANUFACTURER P/N LMK107BJ105MAHT
FB2, FB4: 1K_0.35A; CAP_CHIP_0402_W24L44H24_RFL; MANUFACTURER P/N BLM15AX102SN1D
FB5: NI; CAP_CHIP_0402_W24L44H24_RFL; MANUFACTURER P/N DoNotPurchase; not fitted
R26, R27, R28, R32, R45, R55, R56, R59, R73, R91, R140, R161, R168, R184: NI; CAP_CHIP_0402_W24L44H24_RFL; MANUFACTURER P/N DoNotPurchase; not fitted
R29, R47, R57, R58, R72, R141, R143, R159, R197: 0; CAP_CHIP_0402_W24L44H24_RFL; MANUFACTURER P/N CRG0402ZR
R33, R44, R178, R183, R195: 10K; CAP_CHIP_0402_W24L44H24_RFL; MANUFACTURER P/N RMCF0402FT10K0
R61, R64: 1K; CAP_CHIP_0402_W24L44H24_RFL; MANUFACTURER P/N RC0402FR-071KL
R89: 200; CAP_CHIP_0402_W24L44H24_RFL; MANUFACTURER P/N RC0402FR-07200RL
R180, R196: 20; CAP_CHIP_0402_W24L44H24_RFL; MANUFACTURER P/N RMCF0402JT20R0
SW2: PTS820J15; SWITCH_W3.9L2.9H2.5_6PIN; MANUFACTURER P/N PTS820J15KPSMTRLFS
U12: 74AUP2G32RA3-7; DIODE_W1.25L1.05H0.35_8PIN; MANUFACTURER P/N 74AUP2G32RA3-7
U22: TCK106AG; IC_0.4_W0.79L0.79H0.59_4PIN; MANUFACTURER P/N TCK106AG,LF
U32: STM32H753VIT6; IC_QUAD_0.5_W14L14H1.6_100PIN; MANUFACTURER P/N STM32H743VIT6TR
U34: LMK1C1102PW; IC_SO_0.65_W4.4L3.0H1.2_8PIN; MANUFACTURER P/N LMK1C1102PWR
X1: 32.768KHz; XTAL_CHIP_W3.3L1.6H0.9_2PIN; MANUFACTURER P/N FC-135 32.7680KA-AG5
Y2: TCXO_20.0_FOX924B; XTAL_CHIP_W5.2L7.2H2_4PIN; MANUFACTURER P/N FT5HNBPK20.0-T1

Connections:
ADC_IN: U32.31 (PA7)
ADC_IP: U32.30 (PA6)
ADC_QN: U32.33 (PC5)
ADC_QP: U32.32 (PC4)
ALT_SCL: U32.92 (PB6)
ALT_SDA: U32.93 (PB7)
C20M_EN: R91.2, U22.B2 (CONTROL), U32.88 (PD7)
CLK_20M: R196.2, U34.1 (CLKIN)
CLK_CPU_20M: R180.2, U32.12 (PH0-OSC_IN)
CLK_DDS: R89.2
CNT_AGC_HOLD: U32.37 (PE7)
CNT_AGC_RST: U32.38 (PE8)
CNT_ANT_SEL: U32.4 (PE5)
CNT_DEMOD_ON: U32.7 (PC13)
CNT_FEM_EN: U32.59 (PD12)
CNT_HP_Tx: U32.3 (PE4)
CNT_LNA_BYP: U32.98 (PE1)
CNT_LO_Rx: U32.5 (PE6)
CNT_PWR_Com: U32.87 (PD6)
CNT_PWR_Main: U32.67 (PA8)
CNT_PWR_RNG: U32.15 (PC0)
CNT_RNG/TRXn: U32.40 (PE10)
CNT_RNG_Tx: U32.1 (PE2)
CNT_Rx: U32.2 (PE3)
CRG_SHDNn: U32.66 (PC9)
DDS_CE: U32.36 (PB2)
DDS_DATA: U32.62 (PD15)
DDS_DCLK: U32.63 (PC6)
DDS_LE: U32.61 (PD14)
DDS_MOD: U32.39 (PE9)
DDS_MUXOUT: U32.60 (PD13)
DDS_TRIG1: U32.25 (PA3)
DDS_TRIG2: U32.97 (PE0)
EX_BT_CK: U32.46 (PB10)
EX_BT_CS: U32.64 (PC7)
EX_BT_IRQ: U32.65 (PC8)
EX_BT_MISO: U32.17 (PC2_C)
EX_BT_MOSI: U32.16 (PC1)
EX_GPIO_1: U32.47 (PB11)
EX_GPIO_2: U32.82 (PD1)
EX_GPIO_3: R59.1
EX_GPS_INT: U32.86 (PD5)
EX_GPS_RSTN: U32.44 (PE14)
EX_GPS_RXD: U32.23 (PA1)
EX_GPS_TMPLS: R45.1
EX_GPS_TXD: U32.22 (PA0-WKUP)
EX_I2C_2_SCL: R161.2
EX_I2C_2_SDA: R168.2
Ex_Com_On: R73.1
GND: C40.1, C41.1, C42.1, C47.1, C66.1, C73.1, C74.1, C75.1, C79.1, C125.2, C126.2, C127.1, C128.1, C158.1, C165.1, C166.1, C174.2, C181.2, C182.1, C185.1, R33.2, R44.2, R57.1, R58.1, R184.1, SW2.1 (p1), SW2.3 (p3), SW2.4 (p4), SW2.5 (p5), SW2.6 (p6), U12.4 (GND), U22.B1 (GND), U32.10 (VSS_1), U32.26 (VSS_2), U32.49 (VSS_3), U32.74 (VSS_4), U32.99 (VSS_5), U34.4 (GND), Y2.2 (GND)
GND_SIGNAL: C27.1, C28.1, C30.1, C32.1, C36.1, R26.1, R27.1, U32.19 (VSSA)
G_Config_1: R56.2, R58.2, U32.84 (PD3)
G_Config_2__Ex_GPIO_3: R55.2, R57.2, R59.2, U32.85 (PD4)
LED_BLUEn: U32.57 (PD10)
LED_GREENn: U32.56 (PD9)
LED_REDn: U32.55 (PD8)
MS_INT: U32.24 (PA2)
MS_SCL: R161.1, U32.95 (PB8)
MS_SDA: R168.1, U32.96 (PB9)
unnamed: C27.2, C28.2, R27.2, R28.2, R29.1, U32.20 (VREF+)
unnamed: C30.2, C32.2, FB2.2, R29.2, U32.21 (VDDA)
unnamed: C79.2, FB4.1, FB5.1, R91.1, U22.A2 (VIN)
unnamed: C125.1, U32.9 (PC15-OSC32_OUT), X1.2
unnamed: C126.1, U32.8 (PC14-OSC32_IN), X1.1
unnamed: C127.2, R143.2, U32.6 (VBAT)
unnamed: C66.2, C166.2, U32.48 (VCAP1), U32.73 (VCAP2)
unnamed: R32.2, R33.1, U32.94 (BOOT0)
unnamed: R45.2, R47.2, U32.35 (PB1)
unnamed: R61.1, U32.43 (PE13)
unnamed: R64.1, U32.42 (PE12)
unnamed: R72.2, R73.2, U32.58 (PD11)
unnamed: R89.1, U34.8 (Y1)
unnamed: R140.2, R141.2, U32.28 (PA4)
unnamed: R178.2, U32.52 (PB13)
unnamed: R180.1, U34.3 (Y0)
unnamed: R183.2, U32.68 (PA9)
unnamed: R184.2, Y2.1 (NC)
unnamed: R195.1, U34.2 (1G)
unnamed: R196.1, Y2.3 (OUT)
PBn: U32.83 (PD2)
PS_Sync: R72.1
RST: C182.2, R197.1, SW2.2 (p2), U32.14 (NRST)
TCK: U32.76 (PA14)
TDI: U32.77 (PA15)
TDO: U32.89 (PB3)
TMS: U32.72 (PA13)
TRN_CSn: U32.45 (PE15)
TRN_DIG2: R64.2, U12.1 (I0)
TRN_DIG3: R61.2, U12.2 (I1)
TRN_IRQ: U32.81 (PD0)
TRN_MISO: U32.79 (PC11)
TRN_MOSI: U32.80 (PC12)
TRN_RSTN: U32.91 (PB5)
TRN_SCK: U32.78 (PC10)
TRN_SLP_TR: U32.41 (PE11)
Timer Reset: R44.1, U12.7 (O), U32.29 (PA5)
USB1_DM: U32.70 (PA11)
USB1_DP: U32.71 (PA12)
USB1_ID: U32.69 (PA10)
USB2_DM: U32.53 (PB14)
USB2_DP: U32.54 (PB15)
USB2_ID: U32.51 (PB12)
USB_PWR: R159.2, U32.50 (VDD_3)
VAGC_EXT: R140.1
VAGC_FB: U32.34 (PB0)
VBAT_Sense: U32.18 (PC3_C)
VCMO_ADC: R26.2, R28.1
VDD_20M: C174.1, C181.1, C185.2, R195.2, U22.A1 (VOUT), U34.6 (VDD), Y2.4 (VCC)
V_3.3_Comm: C47.2, U12.8 (VCC)
V_3.3_Main: C40.2, C41.2, C42.2, C73.2, C74.2, C128.2, C158.2, C165.2, FB4.2, R32.1, R55.1, R56.1, R143.1, R159.1, U32.11 (VDD_1), U32.27 (VDD_2), U32.75 (VDD_4), U32.100 (VDD_5)
V_3.3_RNG: C36.2, C75.2, FB2.1, FB5.2
V_USB1_VBUS: R183.1
V_USB2_VBUS: R178.1
nCharge: R141.1
nExt_PWR_ind: R47.1
nSRST: R197.2
nTRST: U32.90 (PB4)

Notes on the sheet:
DP and DM are 90ohm Diferential pair
ADC_IN and ADC_IP are Diferential pair
ADC_QN and ADC_QP are Diferential pair
PLACE A CAP NEAR EACH POWER PIN
TRANSCEIVER
EXPANSION GPIOs
DEMODULATOR
JTAG
FRONT END BLOCK
DDS
MOTION SENSOR
R89 should be 0ohm if R81 is installed
EXPANSION GP I2C
POWER
PLACE A CAP NEAR EACH PIN
EXPANSION BLUETOOTH
ALTIMETER
EXPANSION GPS
LQFP-100
SWITCHES
ESR < 100m
LEDs
USB CIVILIAN
CL = 7pF
FRONT END
USB MILITARY
ESR < 600m
D-fault: External Reference
