szohar/TrueLocation_lay/TruelocationRev3.0/TL_connectors.kicad_sch

## KiCad design TruelocationRev3.0/TL_connectors.kicad_sch (2025-07-09)

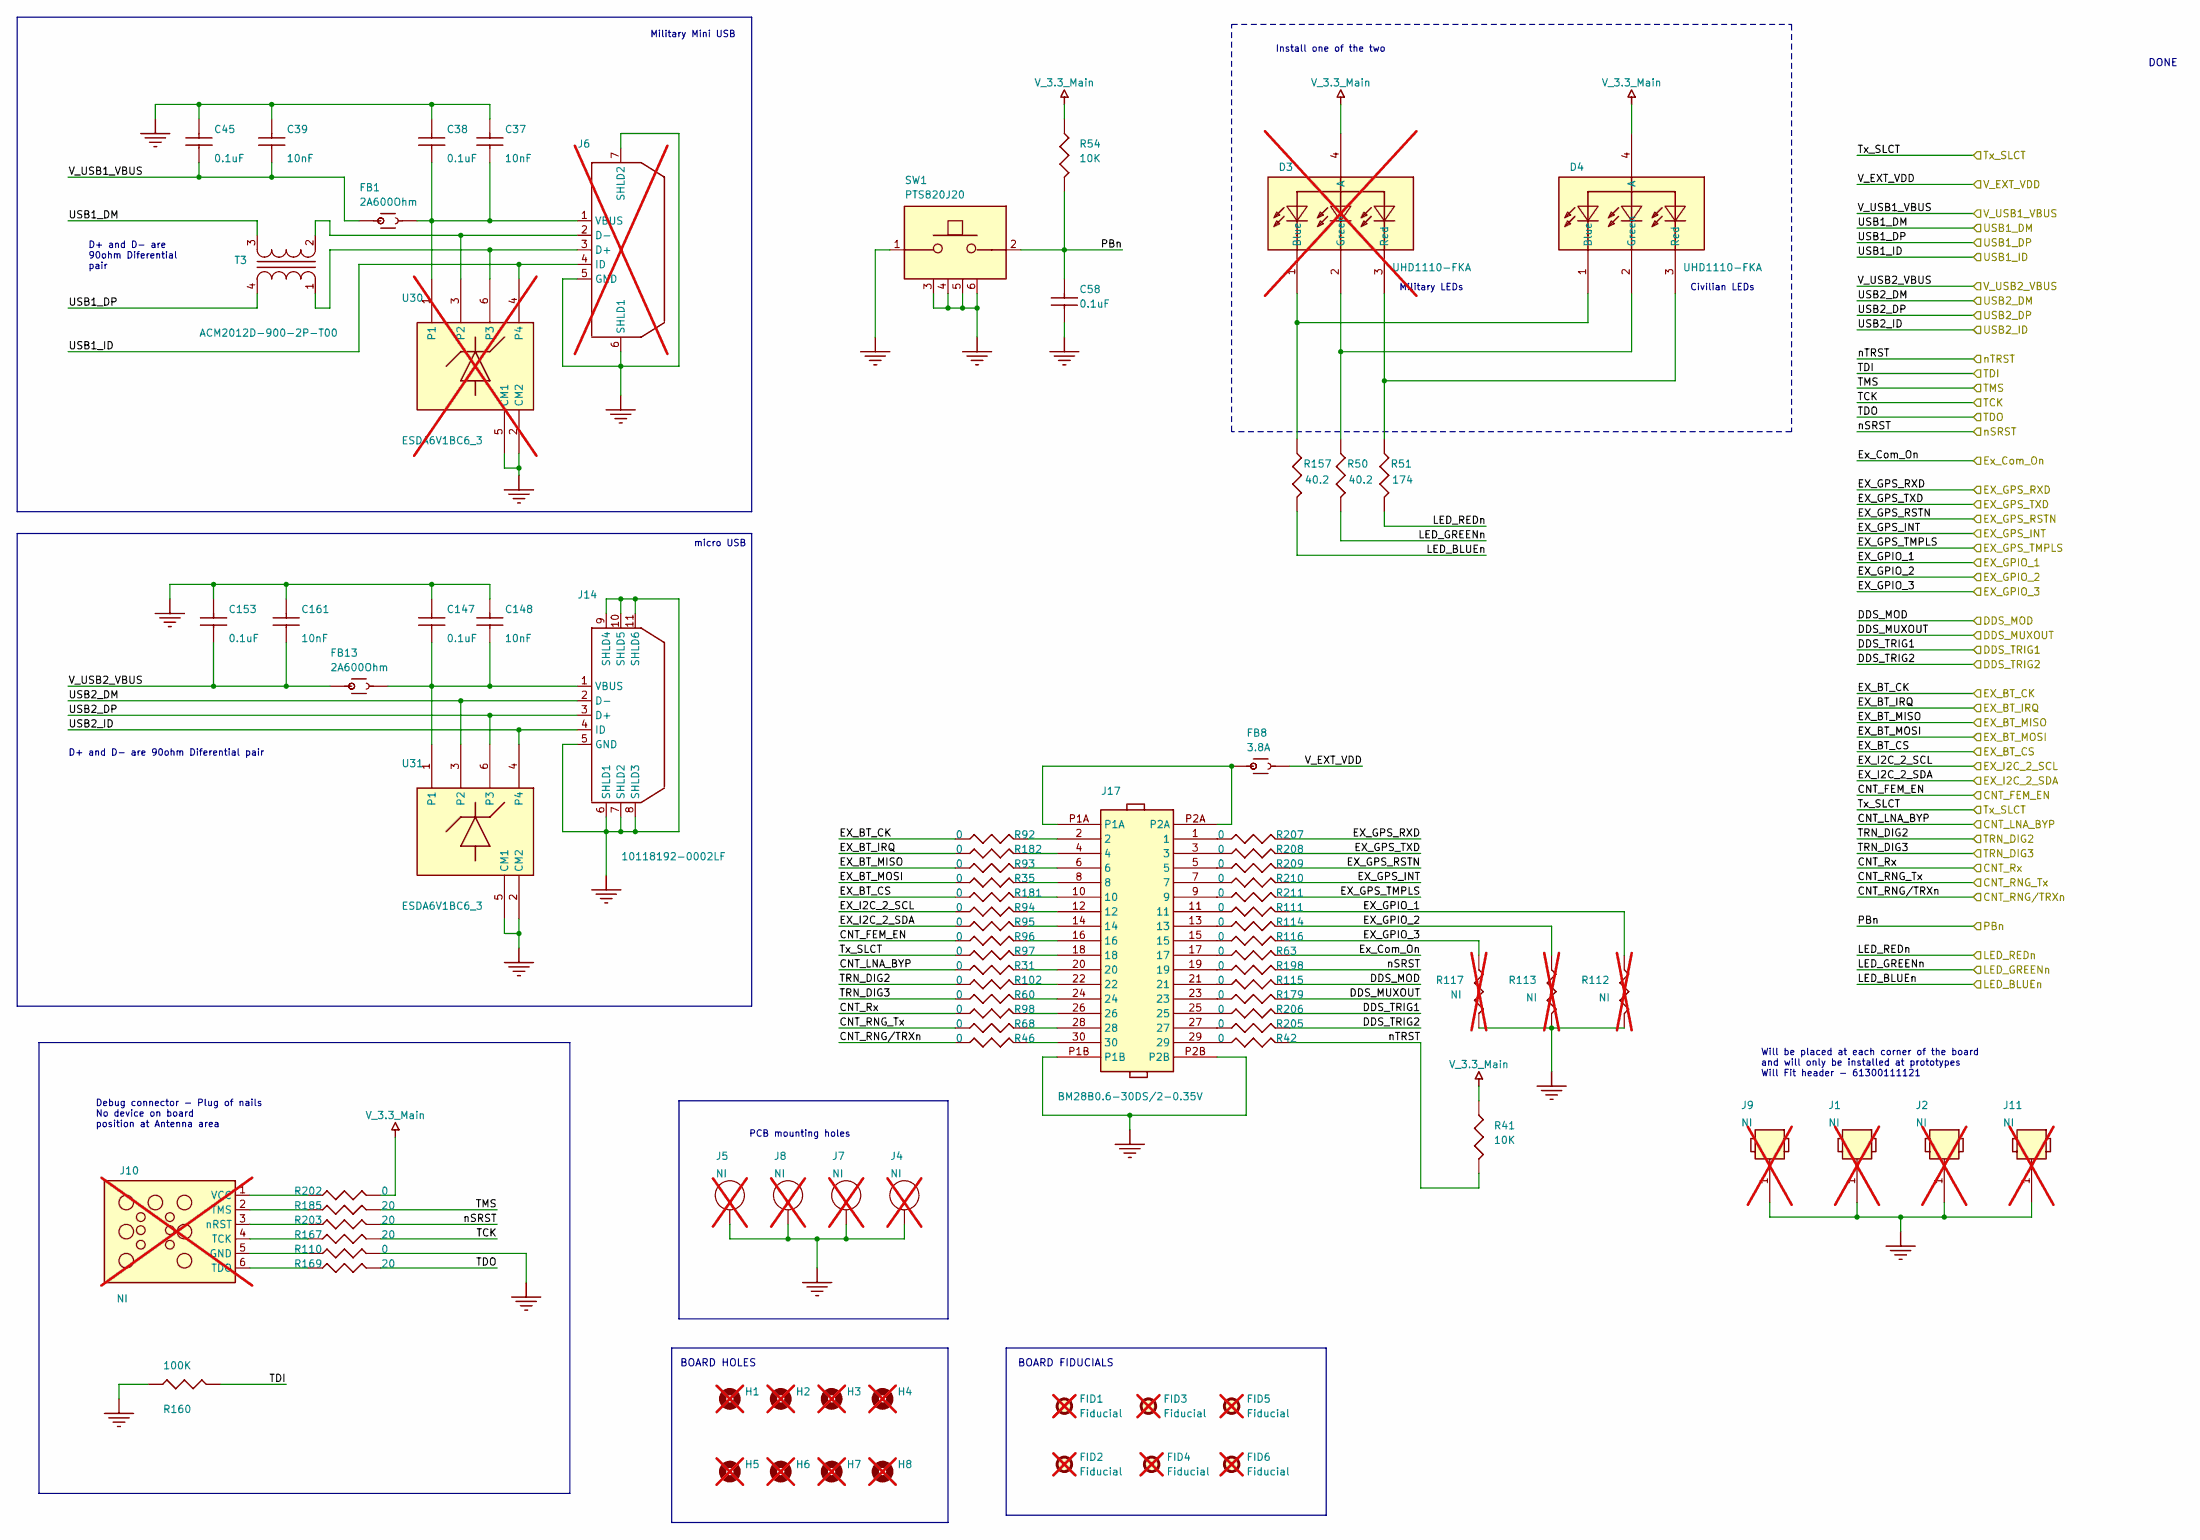
[picture p3: schematic TL_connectors.kicad_sch]

Parts:
C37, C39, C148, C161: 10nF; CAP_CHIP_0402_W24L44H24_RFL; MANUFACTURER P/N CC0402KRX7R9BB103
C38, C45, C58, C147, C153: 0.1uF; CAP_CHIP_0402_W24L44H24_RFL; MANUFACTURER P/N CL05B104KO5NFNC
D3: UHD1110-FKA; LED_CHIP_W1.15L1.15H0.61_4PIN; MANUFACTURER P/N UHD1110-FKA-CL1A13R3Q1BBQFMF3; not fitted
D4: UHD1110-FKA; LED_CHIP_W1.15L1.15H0.61_4PIN; MANUFACTURER P/N UHD1110-FKA-CL1A13R3Q1BBQFMF3
FB1: 2A600Ohm; CAP_CHIP_0603_W40L70H22_RFL; MANUFACTURER P/N BBHV00160808601Y00
FB8: 3.8A; CAP_CHIP_0402_W24L44H24_RFL; MANUFACTURER P/N BLM15KD200SN1D
FB13: 2A600Ohm; CAP_CHIP_0603; MANUFACTURER P/N BBHV00160808601Y00
FID1, FID2, FID3, FID4, FID5, FID6: Fiducial; FIDUCIAL_ONE; not fitted
H1, H2, H3, H4: MountingHole; HOLE_1; not fitted
H5, H6, H7, H8: MountingHole; HOLE_2; not fitted
J1, J2, J9, J11: NI; HEADER_0_0_W80L80_1.1_M_1PIN; MANUFACTURER P/N DoNotPurchase; not fitted
J4, J5, J7, J8: NI; HEADER_1.4HOLE_3.2PAD; MANUFACTURER P/N DoNotPurchase; not fitted
J6: MUSBR-B151-30; D-TYPE_MUSBR_7PIN; MANUFACTURER P/N MUSBR-B151-30; not fitted
J10: NI; PLUG 50_50_W9.9061L19.05_30.378_6PIN; MANUFACTURER P/N DoNotPurchase; not fitted
J14: 10118192-0002LF; USB_ZX62-AB-5PA_5PIN; MANUFACTURER P/N 10118192-0002LF
J17: BM28B0.6-30DS/2-0.35V; CON_BM28B0.6_HRS_30PIN; MANUFACTURER P/N BM28B0.6-30DS/2-0.35V(51)
R31, R35, R42, R46, R60, R63, R68, R92, R93, R94, R95, R96, R97, R98, R102, R110, R111, R114, R115, R116, R179, R181, R182, R198, R202, R205, R206, R207, R208, R209, R210, R211: 0; CAP_CHIP_0402_W24L44H24_RFL; MANUFACTURER P/N CRG0402ZR
R41, R54: 10K; CAP_CHIP_0402_W24L44H24_RFL; MANUFACTURER P/N RMCF0402FT10K0
R50, R157: 40.2; CAP_CHIP_0402_W24L44H24_RFL; MANUFACTURER P/N RMCF0402FT40R2
R51: 174; CAP_CHIP_0402_W24L44H24_RFL; MANUFACTURER P/N RC0402FR-07174RL
R112, R113, R117: NI; CAP_CHIP_0402_W24L44H24_RFL; MANUFACTURER P/N DoNotPurchase; not fitted
R160: 100K; CAP_CHIP_0402_W24L44H24_RFL; MANUFACTURER P/N RMCF0402FT100K
R167, R169, R185, R203: 20; CAP_CHIP_0402_W24L44H24_RFL; MANUFACTURER P/N RMCF0402JT20R0
SW1: PTS820J20; SWITCH_W3.9L2.9H2.5_6PIN; MANUFACTURER P/N PTS820J20MPSMTRLFS
T3: ACM2012D-900-2P-T00; ACM2012D W2.2L1.4H1.3_4PIN; MANUFACTURER P/N ACM2012D-900-2P-T00
U30: ESDA6V1BC6_3; IC_SOT-23_6PIN; MANUFACTURER P/N ESDA6V1BC6; not fitted
U31: ESDA6V1BC6_3; IC_SOT-23_6PIN; MANUFACTURER P/N ESDA6V1BC6

Connections:
CNT_FEM_EN: R96.1
CNT_LNA_BYP: R31.1
CNT_RNG/TRXn: R46.1
CNT_RNG_Tx: R68.1
CNT_Rx: R98.1
DDS_MOD: R115.2
DDS_MUXOUT: R179.2
DDS_TRIG1: R206.2
DDS_TRIG2: R205.2
EX_BT_CK: R92.1
EX_BT_CS: R181.1
EX_BT_IRQ: R182.1
EX_BT_MISO: R93.1
EX_BT_MOSI: R35.1
EX_GPIO_1: R111.2, R112.2
EX_GPIO_2: R113.2, R114.2
EX_GPIO_3: R116.2, R117.2
EX_GPS_INT: R210.2
EX_GPS_RSTN: R209.2
EX_GPS_RXD: R207.2
EX_GPS_TMPLS: R211.2
EX_GPS_TXD: R208.2
EX_I2C_2_SCL: R94.1
EX_I2C_2_SDA: R95.1
Ex_Com_On: R63.2
GND: C37.2, C38.2, C39.2, C45.2, C58.1, C147.2, C148.2, C153.2, C161.2, J1.1, J2.1, J4.1, J5.1, J6.5 (GND), J6.6 (SHLD1), J6.7 (SHLD2), J7.1, J8.1, J9.1, J11.1, J14.5 (GND), J14.6 (SHLD1), J14.7 (SHLD2), J14.8 (SHLD3), J14.9 (SHLD4), J14.10 (SHLD5), J14.11 (SHLD6), J17.P1B, J17.P2B, R110.2, R112.1, R113.1, R117.1, R160.1, SW1.1 (p1), SW1.3 (p3), SW1.4 (p4), SW1.5 (p5), SW1.6 (p6), U30.2 (CM2), U30.5 (CM1), U31.2 (CM2), U31.5 (CM1)
LED_BLUEn: R157.2
LED_GREENn: R50.2
LED_REDn: R51.2
unnamed: C37.1, C38.1, FB1.2, J6.1 (VBUS), U30.1
unnamed: C147.1, C148.1, FB13.2, J14.1 (VBUS), U31.1
unnamed: D3.1 (Blue), D4.1 (Blue), R157.1
unnamed: D3.2 (Green), D4.2 (Green), R50.1
unnamed: D3.3 (Red), D4.3 (Red), R51.1
unnamed: FB8.1, J17.P1A, J17.P2A
unnamed: J6.2 (D-), T3.2, U30.3 (P2)
unnamed: J6.3 (D+), T3.1, U30.6 (P3)
unnamed: J10.1 (VCC), R202.1
unnamed: J10.2 (TMS), R185.1
unnamed: J10.3 (nRST), R203.1
unnamed: J10.4 (TCK), R167.1
unnamed: J10.5 (GND), R110.1
unnamed: J10.6 (TDO), R169.1
unnamed: J17.1, R207.1
unnamed: J17.2, R92.2
unnamed: J17.3, R208.1
unnamed: J17.4, R182.2
unnamed: J17.5, R209.1
unnamed: J17.6, R93.2
unnamed: J17.7, R210.1
unnamed: J17.8, R35.2
unnamed: J17.9, R211.1
unnamed: J17.10, R181.2
unnamed: J17.11, R111.1
unnamed: J17.12, R94.2
unnamed: J17.13, R114.1
unnamed: J17.14, R95.2
unnamed: J17.15, R116.1
unnamed: J17.16, R96.2
unnamed: J17.17, R63.1
unnamed: J17.18, R97.2
unnamed: J17.19, R198.1
unnamed: J17.20, R31.2
unnamed: J17.21, R115.1
unnamed: J17.22, R102.2
unnamed: J17.23, R179.1
unnamed: J17.24, R60.2
unnamed: J17.25, R206.1
unnamed: J17.26, R98.2
unnamed: J17.27, R205.1
unnamed: J17.28, R68.2
unnamed: J17.29, R42.1
unnamed: J17.30, R46.2
PBn: C58.2, R54.2, SW1.2 (p2)
TCK: R167.2
TDI: R160.2
TDO: R169.2
TMS: R185.2
TRN_DIG2: R102.1
TRN_DIG3: R60.1
Tx_SLCT: R97.1
USB1_DM: T3.3
USB1_DP: T3.4
USB1_ID: J6.4 (ID), U30.4
USB2_DM: J14.2 (D-), U31.3 (P2)
USB2_DP: J14.3 (D+), U31.6 (P3)
USB2_ID: J14.4 (ID), U31.4
V_3.3_Main: D3.4 (A), D4.4 (A), R41.1, R54.1, R202.2
V_EXT_VDD: FB8.2
V_USB1_VBUS: C39.1, C45.1, FB1.1
V_USB2_VBUS: C153.1, C161.1, FB13.1
nSRST: R198.2, R203.2
nTRST: R41.2, R42.2

Notes on the sheet:
D+ and D- are 90ohm Diferential pair
Will be placed at each corner of the board and will only be installed at prototypes Will Fit header - 61300111121
Debug connector - Plug of nails No device on board position at Antenna area
BOARD HOLES
PCB mounting holes
DONE
Military LEDs
Install one of the two
Civilian LEDs
micro USB
Military Mini USB
D+ and D- are 90ohm Diferential pair
BOARD FIDUCIALS
