szohar/TrueLocation_lay/TruelocationRev3.0/TL_demodulator.kicad_sch

## KiCad design TruelocationRev3.0/TL_demodulator.kicad_sch (2025-07-10)

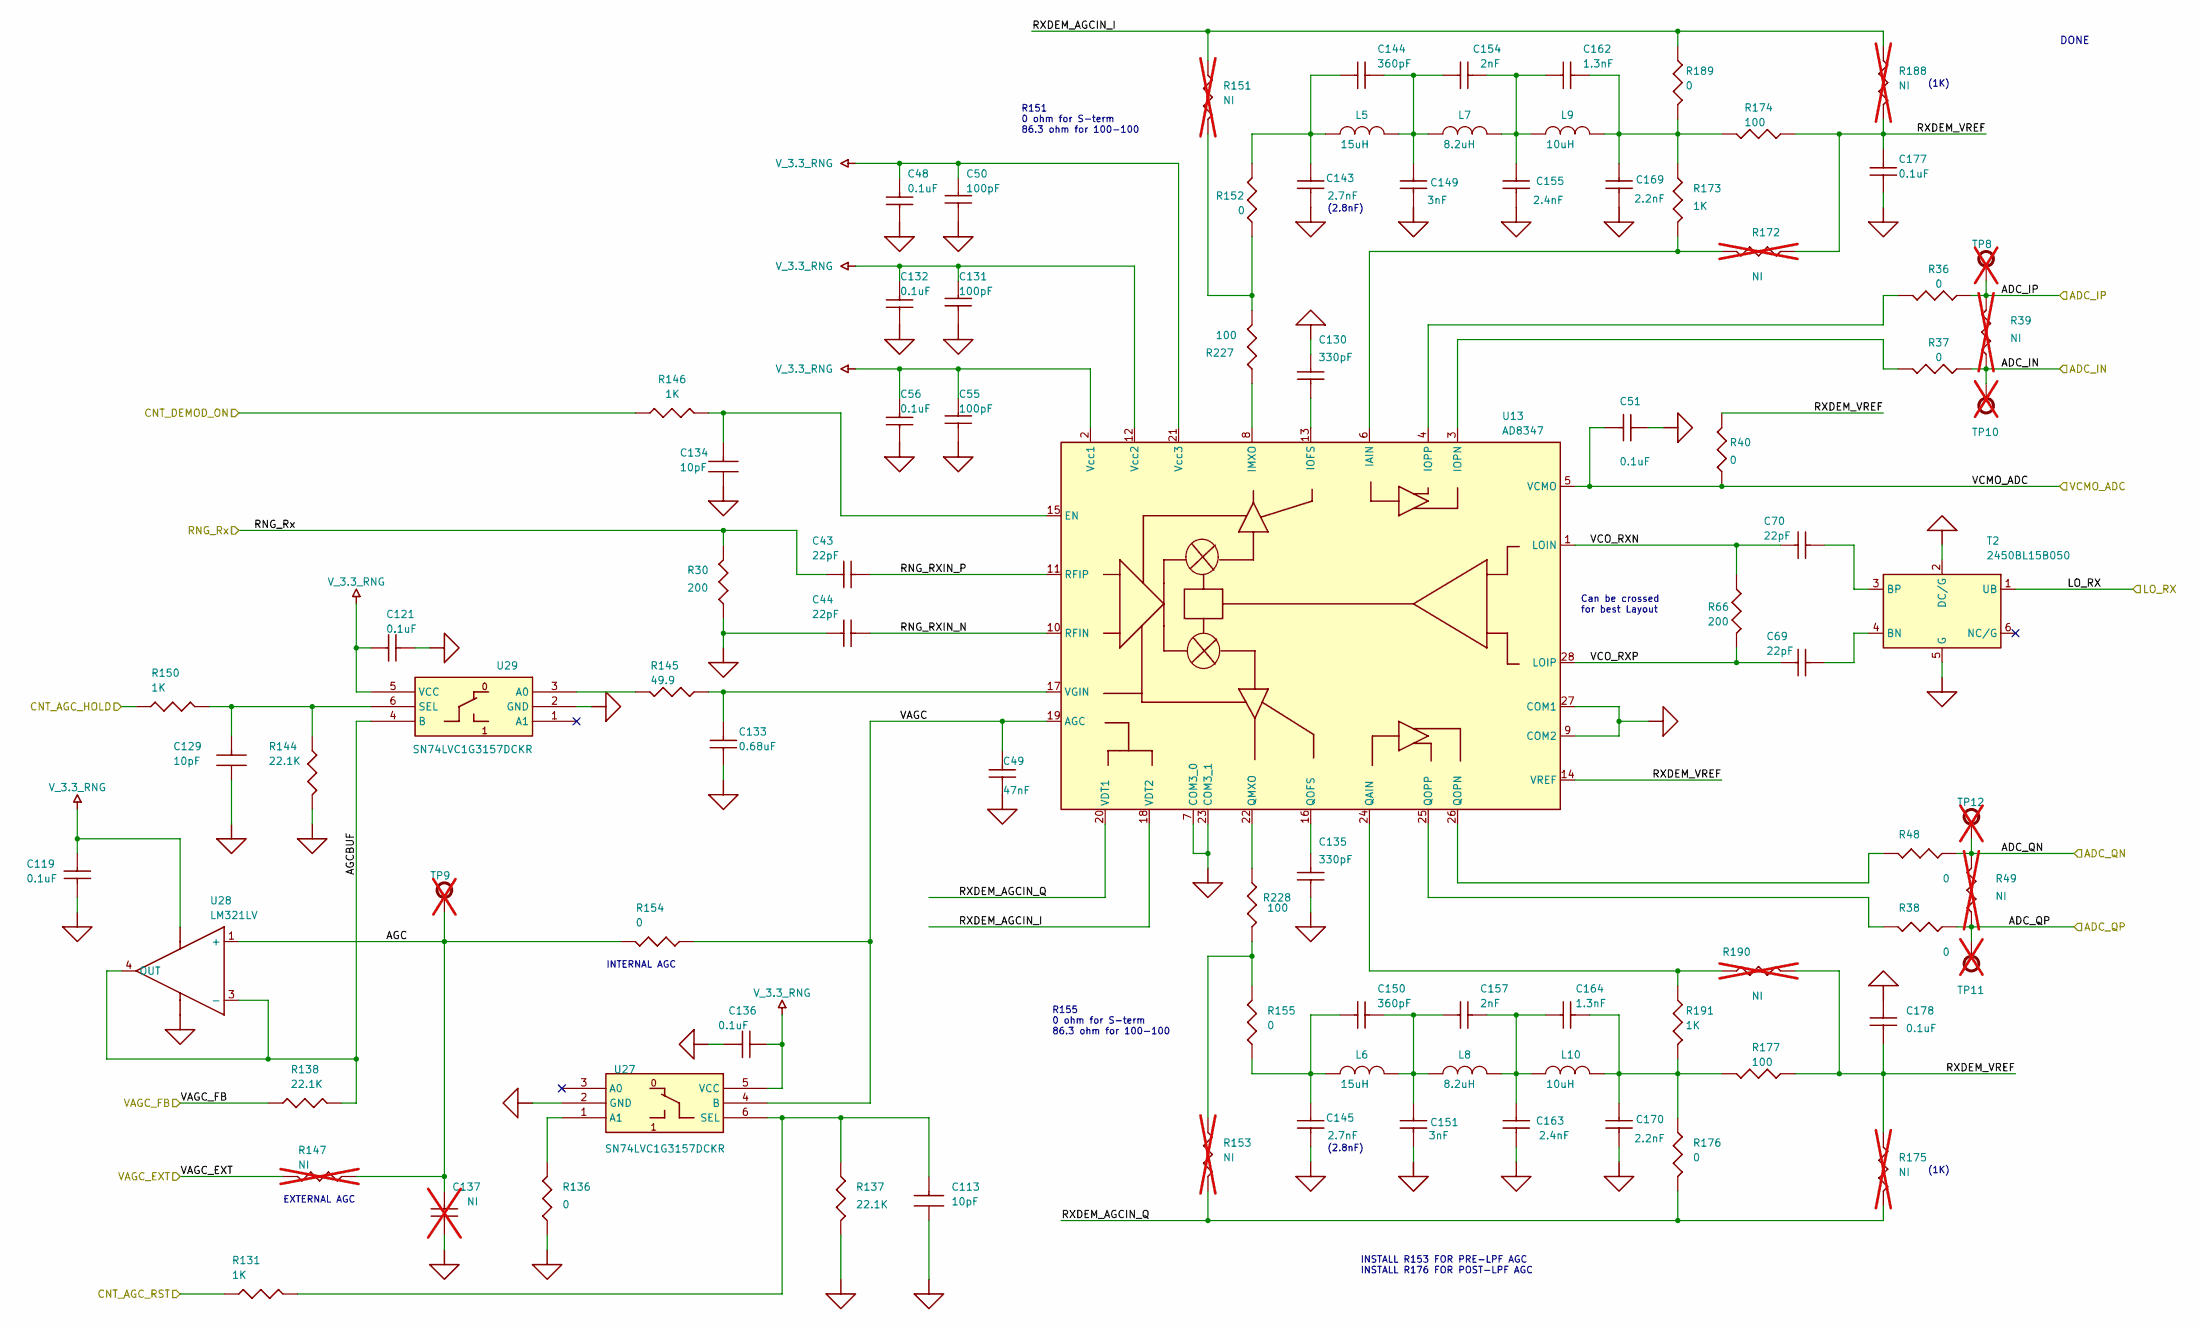
[picture p4: schematic TL_demodulator.kicad_sch]

Parts:
C43, C44, C69, C70: 22pF; CAP_CHIP_0402_W24L44H24_RFL; MANUFACTURER P/N GCM1555C1H220JA16D
C48, C51, C56, C119, C121, C132, C136, C177, C178: 0.1uF; CAP_CHIP_0402_W24L44H24_RFL; MANUFACTURER P/N CL05B104KO5NFNC
C49: 47nF; CAP_CHIP_0402_W24L44H24_RFL; MANUFACTURER P/N CC0402JRX7R9BB473
C50, C55, C131: 100pF; CAP_CHIP_0402_W24L44H24_RFL; MANUFACTURER P/N CL05C101JB5NNNC
C113, C129, C134: 10pF; CAP_CHIP_0402_W24L44H24_RFL; MANUFACTURER P/N C0402C100J3GACTU
C130, C135: 330pF; CAP_CHIP_0402_W24L44H24_RFL; MANUFACTURER P/N UMK105CG331JVHF
C133: 0.68uF; CAP_CHIP_0402_W24L44H24_RFL; MANUFACTURER P/N CC0402KRX5R6BB684
C137: NI; CAP_CHIP_0402_W24L44H24_RFL; MANUFACTURER P/N DoNotPurchase; not fitted
C143, C145: 2.7nF; CAP_CHIP_0402_W24L44H24_RFL; MANUFACTURER P/N CC0402JRX7R9BB272
C144, C150: 360pF; CAP_CHIP_0402_W24L44H24_RFL; MANUFACTURER P/N GCM1555C1H361JA16D
C149, C151: 3nF; CAP_CHIP_0402_W24L44H24_RFL; MANUFACTURER P/N GRM1557U1A302JA01D
C154, C157: 2nF; CAP_CHIP_0402_W24L44H24_RFL; MANUFACTURER P/N 04025C202JAT2A
C155, C163: 2.4nF; CAP_CHIP_0402_W24L44H24_RFL; MANUFACTURER P/N GRM1557U1A242JA01D
C162, C164: 1.3nF; CAP_CHIP_0402_W24L44H24_RFL; MANUFACTURER P/N C0402C132J5GACTU
C169, C170: 2.2nF; CAP_CHIP_0402_W24L44H24_RFL; MANUFACTURER P/N CL05B222JB5NNNC
L5, L6: 15uH; CAP_CHIP_0603; MANUFACTURER P/N MLF1608C150KTA00
L7, L8: 8.2uH; CAP_CHIP_0603_W40L70H22_RFL; MANUFACTURER P/N AIML-0603-8R2K-T
L9, L10: 10uH; CAP_CHIP_0603_W40L70H22_RFL; MANUFACTURER P/N AIML-0603-100K-T
R30, R66: 200; CAP_CHIP_0402_W24L44H24_RFL; MANUFACTURER P/N RC0402FR-07200RL
R36, R37, R38, R40, R48, R136, R152, R154, R155, R176, R189: 0; CAP_CHIP_0402_W24L44H24_RFL; MANUFACTURER P/N CRG0402ZR
R39, R49, R147, R151, R153, R172, R175, R188, R190: NI; CAP_CHIP_0402_W24L44H24_RFL; MANUFACTURER P/N DoNotPurchase; not fitted
R131, R146, R150, R173, R191: 1K; CAP_CHIP_0402_W24L44H24_RFL; MANUFACTURER P/N RC0402FR-071KL
R137, R138, R144: 22.1K; CAP_CHIP_0402_W24L44H24_RFL; MANUFACTURER P/N RMCF0402FT22K1
R145: 49.9; CAP_CHIP_0402_W24L44H24_RFL; MANUFACTURER P/N RC0402FR-0749R9L
R174, R177, R227, R228: 100; CAP_CHIP_0402_W24L44H24_RFL; MANUFACTURER P/N RMCF0402FT100R
T2: 2450BL15B050; COIL_MOLD_2.1x1.35_6PIN; MANUFACTURER P/N 2450BL15B0050001E
TP8, TP9, TP10, TP11, TP12: TEST POINT; HEADER_0_0_W80L80_0.7_M_1PIN; MANUFACTURER P/N DoNotPurchase; not fitted
U13: AD8347; IC_SO_0.65_W4.4L9.7H1.2_28PIN; MANUFACTURER P/N AD8347ARUZ-REEL7
U27, U29: SN74LVC1G3157DCKR; IC_DCK_W2.15L1.40H1.10_6PIN; MANUFACTURER P/N SN74LVC1G3157DCKR
U28: LM321LV; IC_SC70-6_5OF6PIN; MANUFACTURER P/N LM321LVIDCKR

Connections:
ADC_IN: R37.1, R39.1, TP10.1
ADC_IP: R36.1, R39.2, TP8.1
ADC_QN: R48.1, R49.2, TP12.1
ADC_QP: R38.1, R49.1, TP11.1
AGC: C137.1, R147.1, R154.2, TP9.1, U28.1 (+)
AGCBUF: R138.1, U28.3 (-), U28.4 (OUT), U29.4 (B)
CNT_AGC_HOLD: R150.1
CNT_AGC_RST: R131.1
CNT_DEMOD_ON: R146.1
GND_SIGNAL: C44.1, C48.1, C49.1, C50.2, C51.1, C55.2, C56.1, C113.1, C119.2, C121.2, C129.1, C130.1, C131.2, C132.1, C133.1, C134.1, C135.1, C136.2, C137.2, C143.2, C145.2, C149.2, C151.2, C155.2, C163.2, C169.2, C170.2, C177.1, C178.1, R30.1, R136.1, R137.1, R144.1, T2.2 (DC/G), T2.5 (G), U13.7 (COM3_0), U13.9 (COM2), U13.23 (COM3_1), U13.27 (COM1), U27.2 (GND), U28.2 (V-), U29.2 (GND)
LO_RX: T2.1 (UB)
unnamed: C69.2, T2.4 (BN)
unnamed: C70.2, T2.3 (BP)
unnamed: C113.2, R131.2, R137.2, U27.6 (SEL)
unnamed: C129.2, R144.2, R150.2, U29.6 (SEL)
unnamed: C130.2, U13.13 (IOFS)
unnamed: C133.2, R145.1, U13.17 (VGIN)
unnamed: C134.2, R146.2, U13.15 (EN)
unnamed: C135.2, U13.16 (QOFS)
unnamed: C143.1, C144.1, L5.2, R152.2
unnamed: C144.2, C149.1, C154.1, L5.1, L7.2
unnamed: C145.1, C150.1, L6.2, R155.1
unnamed: C150.2, C151.1, C157.1, L6.1, L8.2
unnamed: C154.2, C155.1, C162.1, L7.1, L9.2
unnamed: C157.2, C163.1, C164.1, L8.1, L10.2
unnamed: C162.2, C169.1, L9.1, R173.1, R174.2, R189.2
unnamed: C164.2, C170.1, L10.1, R176.1, R177.2, R191.2
unnamed: R36.2, U13.4 (IOPP)
unnamed: R37.2, U13.3 (IOPN)
unnamed: R38.2, U13.25 (QOPP)
unnamed: R48.2, U13.26 (QOPN)
unnamed: R136.2, U27.1 (A1)
unnamed: R145.2, U29.3 (A0)
unnamed: R151.2, R152.1, R227.2
unnamed: R153.1, R155.2, R228.2
unnamed: R172.2, R173.2, U13.6 (IAIN)
unnamed: R190.1, R191.1, U13.24 (QAIN)
unnamed: R227.1, U13.8 (IMXO)
unnamed: R228.1, U13.22 (QMXO)
RNG_RXIN_N: C44.2, U13.10 (RFIN)
RNG_RXIN_P: C43.2, U13.11 (RFIP)
RNG_Rx: C43.1, R30.2
RXDEM_AGCIN_I: R151.1, R188.1, R189.1, U13.18 (VDT2)
RXDEM_AGCIN_Q: R153.2, R175.2, R176.2, U13.20 (VDT1)
RXDEM_VREF: C177.2, C178.2, R40.2, R172.1, R174.1, R175.1, R177.1, R188.2, R190.2, U13.14 (VREF)
VAGC: C49.2, R154.1, U13.19 (AGC), U27.4 (B)
VAGC_EXT: R147.2
VAGC_FB: R138.2
VCMO_ADC: C51.2, R40.1, U13.5 (VCMO)
VCO_RXN: C70.1, R66.1, U13.1 (LOIN)
VCO_RXP: C69.1, R66.2, U13.28 (LOIP)
V_3.3_RNG: C48.2, C50.1, C55.1, C56.2, C119.1, C121.1, C131.1, C132.2, C136.1, U13.2 (Vcc1), U13.12 (Vcc2), U13.21 (Vcc3), U27.5 (VCC), U28.5 (V+), U29.5 (VCC)

Notes on the sheet:
INSTALL R153 FOR PRE-LPF AGC INSTALL R176 FOR POST-LPF AGC
Can be crossed for best Layout
R155 0 ohm for S-term 86.3 ohm for 100-100
R151 0 ohm for S-term 86.3 ohm for 100-100
(2.8nF)
(1K)
EXTERNAL AGC
INTERNAL AGC
DONE
