szohar/TrueLocation_lay/TruelocationRev3.0/TL_frontend.kicad_sch

## KiCad design TruelocationRev3.0/TL_frontend.kicad_sch (2025-07-10)

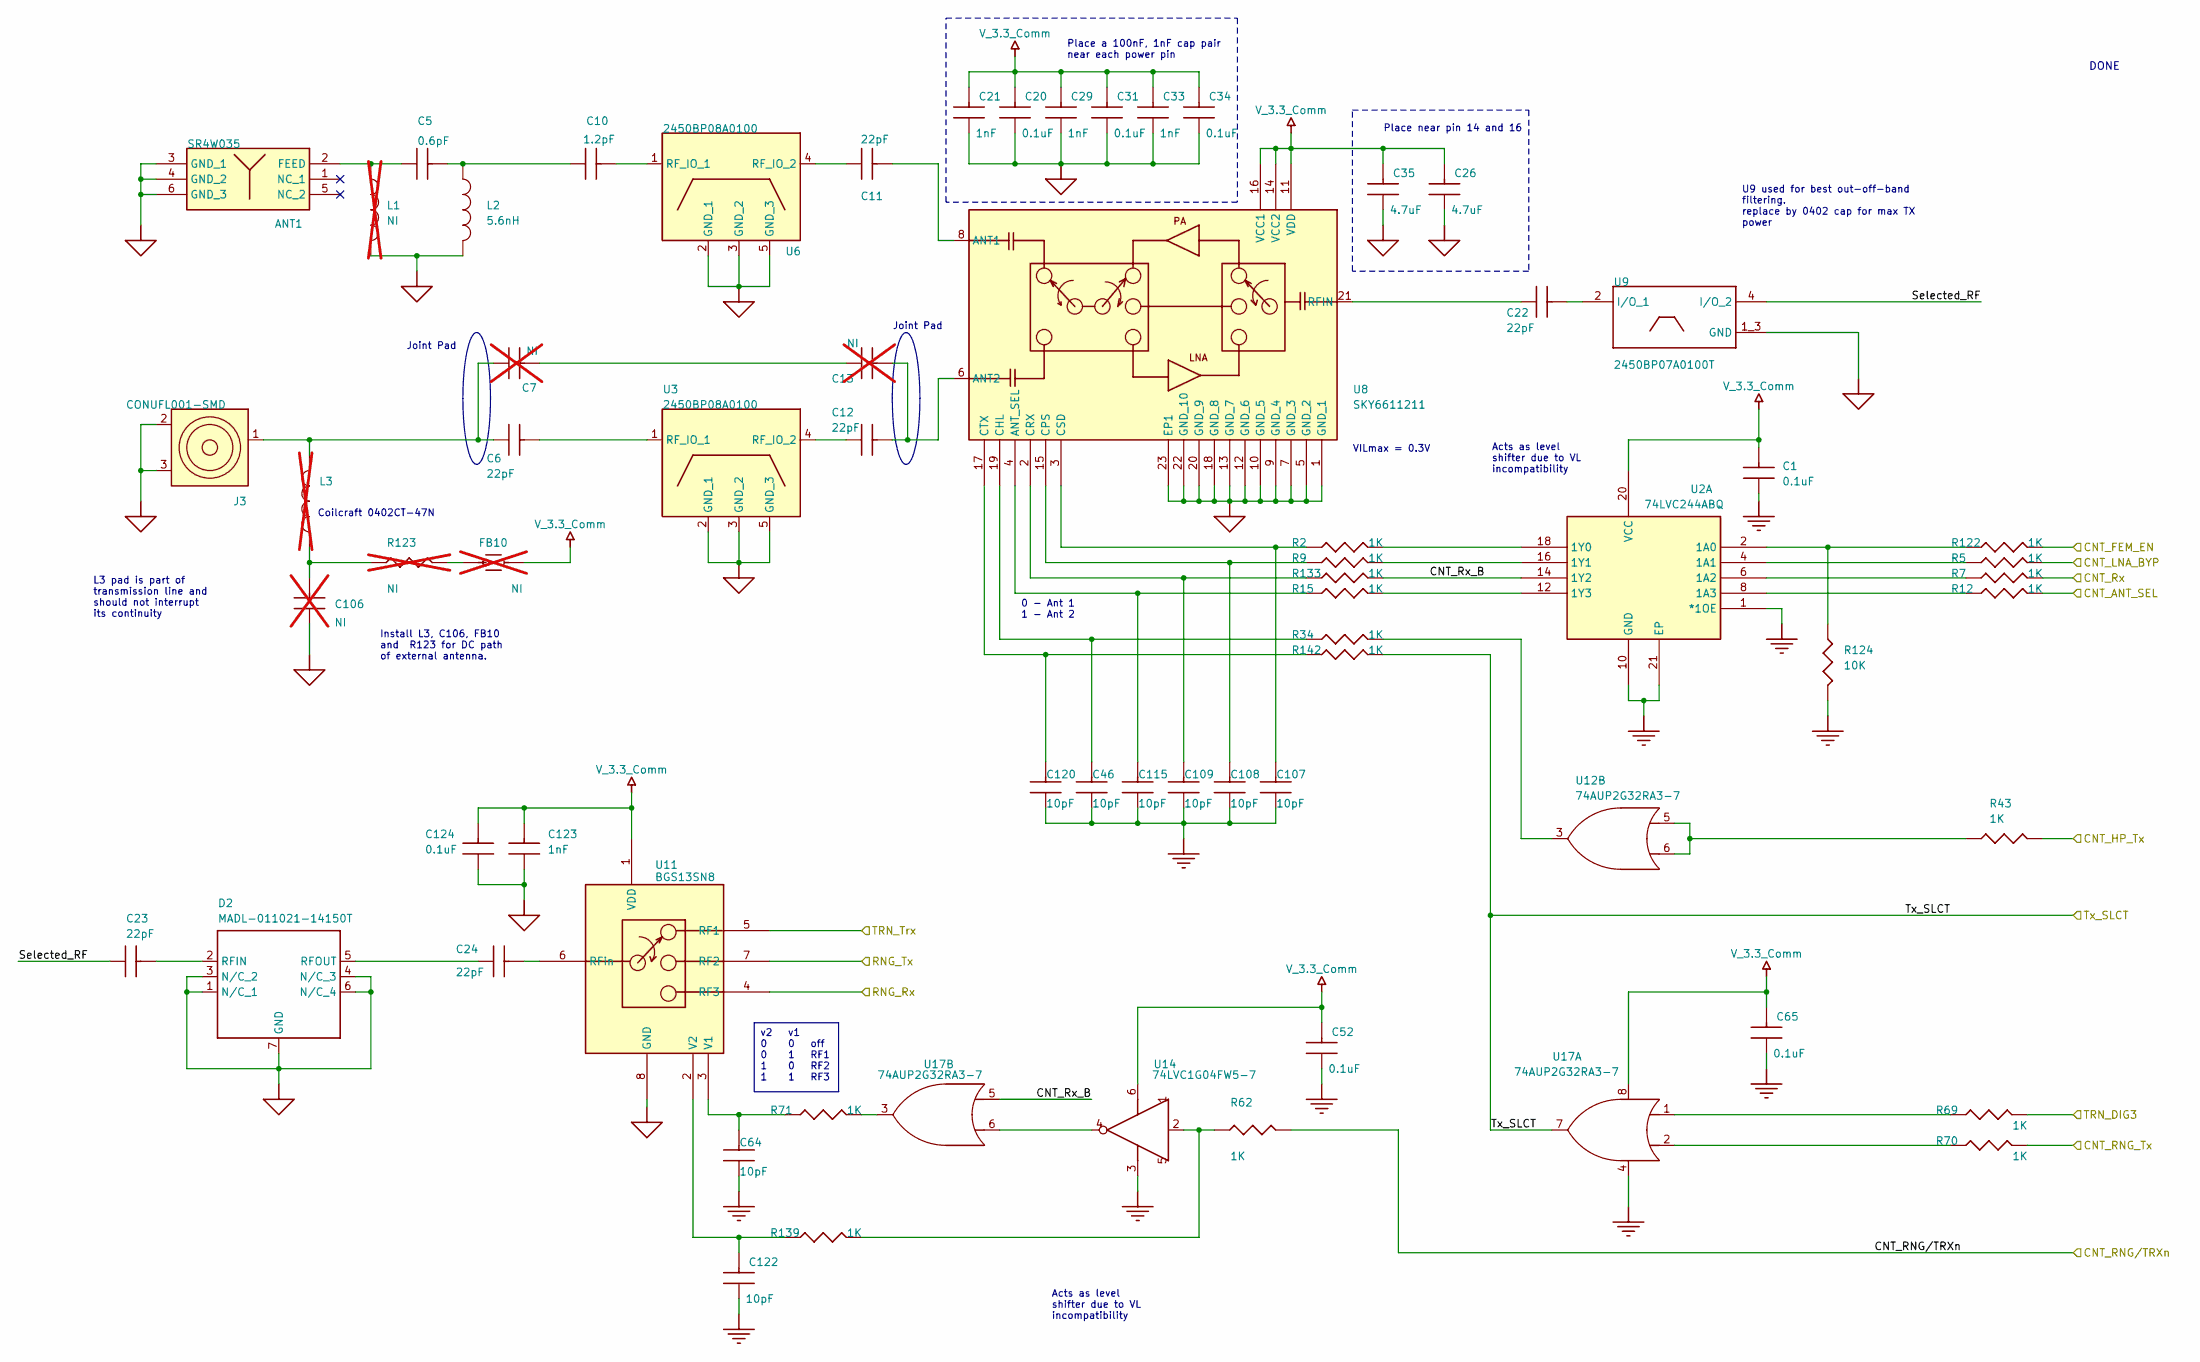
[picture p5: schematic TL_frontend.kicad_sch]

Parts:
ANT1: SR4W035; IC_ANT_W6.1L4.1H0.5_6PIN; MANUFACTURER P/N SR4W035
C1, C20, C31, C34, C52, C65, C124: 0.1uF; CAP_CHIP_0402_W24L44H24_RFL; MANUFACTURER P/N CL05B104KO5NFNC
C5: 0.6pF; CAP_CHIP_0402_W24L44H24_RFL; MANUFACTURER P/N QSCF500Q0R6A1GV001T
C6, C11, C12, C22, C23, C24: 22pF; CAP_CHIP_0402_W24L44H24_RFL; MANUFACTURER P/N GCM1555C1H220JA16D
C7, C13, C106: NI; CAP_CHIP_0402_W24L44H24_RFL; MANUFACTURER P/N C0603C220J5GACTU; not fitted
C10: 1.2pF; CAP_CHIP_0402_W24L44H24_RFL; MANUFACTURER P/N GJM1555C1H1R2WB01D
C21, C29, C33, C123: 1nF; CAP_CHIP_0402_W24L44H24_RFL; MANUFACTURER P/N C0402C102K5RACTU
C26, C35: 4.7uF; CAP_CHIP_0603_W40L70H22_RFL; MANUFACTURER P/N GRM188R61C475KE11D
C46, C64, C107, C108, C109, C115, C120, C122: 10pF; CAP_CHIP_0402_W24L44H24_RFL; MANUFACTURER P/N C0402C100J3GACTU
D2: MADL-011021-14150T; IC_TDFN_0.4_W1.5L1.2H0.8_6PIN; MANUFACTURER P/N MADL-011021-14150T
FB10: NI; CAP_CHIP_0402_W24L44H24_RFL; MANUFACTURER P/N DoNotPurchase; not fitted
J3: CONUFL001-SMD; CON UFL 3PIN; MANUFACTURER P/N CONUFL001-SMD-T
L1: NI; CAP_CHIP_0402; MANUFACTURER P/N DoNotPurchase; not fitted
L2: 5.6nH; CAP_CHIP_0402; MANUFACTURER P/N LQG15HN5N6S02D
L3: NI; CAP_CHIP_0402_W24L44H24_RFL; MANUFACTURER P/N DoNotPurchase; not fitted
R2, R5, R7, R9, R12, R15, R34, R43, R62, R69, R70, R71, R122, R133, R139, R142: 1K; CAP_CHIP_0402_W24L44H24_RFL; MANUFACTURER P/N RC0402FR-071KL
R123: NI; CAP_CHIP_0402_W24L44H24_RFL; MANUFACTURER P/N DoNotPurchase; not fitted
R124: 10K; CAP_CHIP_0402_W24L44H24_RFL; MANUFACTURER P/N RMCF0402FT10K0
U2: 74LVC244ABQ; IC_QFN_W4.6L2.6H1_21PIN; MANUFACTURER P/N 74LVC244ABQ,115
U3, U6: 2450BP08A0100; COIL_MOLD_1.55x1.25_5PIN; MANUFACTURER P/N 2450BP08A0100
U8: SKY6611211; IC_QFN_W3L3.5H1.1_23PIN; MANUFACTURER P/N SKY66112-11
U9: 2450BP07A0100T; COIL W1.0L0.5H0.38_3PIN; MANUFACTURER P/N 2450BP07A0100001T
U11: BGS13SN8; IC_BGA_0.4_W1.1L1.1H0.4_8PIN; MANUFACTURER P/N BGS13SN8E6327XTSA1
U12, U17: 74AUP2G32RA3-7; DIODE_W1.25L1.05H0.35_8PIN; MANUFACTURER P/N 74AUP2G32RA3-7
U14: 74LVC1G04FW5-7; DIODE_W1.050L1.050H0.50_6PIN; MANUFACTURER P/N 74LVC1G04FW5-7

Connections:
CNT_ANT_SEL: R12.2
CNT_FEM_EN: R122.2
CNT_HP_Tx: R43.2
CNT_LNA_BYP: R5.2
CNT_RNG/TRXn: R62.2
CNT_RNG_Tx: R70.2
CNT_Rx: R7.2
CNT_Rx_B: R133.2, U2.14 (1Y2), U17.5 (I0)
GND: C1.1, C46.1, C52.1, C64.1, C65.1, C107.1, C108.1, C109.1, C115.1, C120.1, C122.1, R124.2, U2.1 (*1OE), U2.10 (GND), U2.21 (EP), U14.3 (GND), U17.4 (GND)
GND_SIGNAL: ANT1.3 (GND_1), ANT1.4 (GND_2), ANT1.6 (GND_3), C20.1, C21.1, C26.1, C29.1, C31.1, C33.1, C34.1, C35.1, C106.1, C123.1, C124.1, D2.1 (N/C_1), D2.3 (N/C_2), D2.4 (N/C_3), D2.6 (N/C_4), D2.7 (GND), J3.2 (SH1), J3.3 (SH2), L1.2, L2.2, U3.2 (GND_1), U3.3 (GND_2), U3.5 (GND_3), U6.2 (GND_1), U6.3 (GND_2), U6.5 (GND_3), U8.1 (GND_1), U8.5 (GND_2), U8.7 (GND_3), U8.9 (GND_4), U8.10 (GND_5), U8.12 (GND_6), U8.13 (GND_7), U8.18 (GND_8), U8.20 (GND_9), U8.22 (GND_10), U8.23 (EP1), U9.1_3 (GND), U11.8 (GND)
unnamed: ANT1.2 (FEED), C5.1, L1.1
unnamed: C6.1, C7.1, J3.1 (SIG), L3.2
unnamed: C6.2, U3.1 (RF_IO_1)
unnamed: C5.2, C10.1, L2.1
unnamed: C10.2, U6.1 (RF_IO_1)
unnamed: C11.1, U6.4 (RF_IO_2)
unnamed: C11.2, U8.8 (ANT1)
unnamed: C12.1, U3.4 (RF_IO_2)
unnamed: C12.2, C13.2, U8.6 (ANT2)
unnamed: C7.2, C13.1
unnamed: C22.1, U8.21 (RFIN)
unnamed: C22.2, U9.2 (I/O_1)
unnamed: C23.2, D2.2 (RFIN)
unnamed: C24.1, D2.5 (RFOUT)
unnamed: C24.2, U11.6 (RFin)
unnamed: C46.2, R34.1, U8.19 (CHL)
unnamed: C64.2, R71.1, U11.3 (V1)
unnamed: C106.2, L3.1, R123.1
unnamed: C107.2, R2.1, U8.3 (CSD)
unnamed: C108.2, R9.1, U8.15 (CPS)
unnamed: C109.2, R133.1, U8.2 (CRX)
unnamed: C115.2, R15.1, U8.4 (ANT_SEL)
unnamed: C120.2, R142.1, U8.17 (CTX)
unnamed: C122.2, R139.1, U11.2 (V2)
unnamed: FB10.1, R123.2
unnamed: R2.2, U2.18 (1Y0)
unnamed: R5.1, U2.4 (1A1)
unnamed: R7.1, U2.6 (1A2)
unnamed: R9.2, U2.16 (1Y1)
unnamed: R12.1, U2.8 (1A3)
unnamed: R15.2, U2.12 (1Y3)
unnamed: R34.2, U12.3 (O)
unnamed: R43.1, U12.5 (I0), U12.6 (I1)
unnamed: R69.1, U17.1 (I0)
unnamed: R70.1, U17.2 (I1)
unnamed: R71.2, U17.3 (O)
unnamed: R122.1, R124.1, U2.2 (1A0)
unnamed: R62.1, R139.2, U14.2 (I)
unnamed: U14.4 (O), U17.6 (I1)
RNG_Rx: U11.4 (RF3)
RNG_Tx: U11.7 (RF2)
Selected_RF: C23.1, U9.4 (I/O_2)
TRN_DIG3: R69.2
TRN_Trx: U11.5 (RF1)
Tx_SLCT: R142.2, U17.7 (O)
V_3.3_Comm: C1.2, C20.2, C21.2, C26.2, C29.2, C31.2, C33.2, C34.2, C35.2, C52.2, C65.2, C123.2, C124.2, FB10.2, U2.20 (VCC), U8.11 (VDD), U8.14 (VCC2), U8.16 (VCC1), U11.1 (VDD), U14.6 (VCC), U17.8 (VCC)

Notes on the sheet:
Acts as level shifter due to VL incompatibility
v2 v1 0 0 off 0 1 RF1 1 0 RF2 1 1 RF3
Install L3, C106, FB10 and R123 for DC path of external antenna.
0 - Ant 1 1 - Ant 2
L3 pad is part of transmission line and should not interrupt its continuity
Place a 100nF, 1nF cap pair near each power pin
U9 used for best out-off-band filtering. replace by 0402 cap for max TX power
Place near pin 14 and 16
Coilcraft 0402CT-47N
Joint Pad
DONE
VILmax = 0.3V
