szohar/TrueLocation_lay/TruelocationRev3.0/TL_local_oscillator.kicad_sch

## KiCad design TruelocationRev3.0/TL_local_oscillator.kicad_sch (2025-07-09)

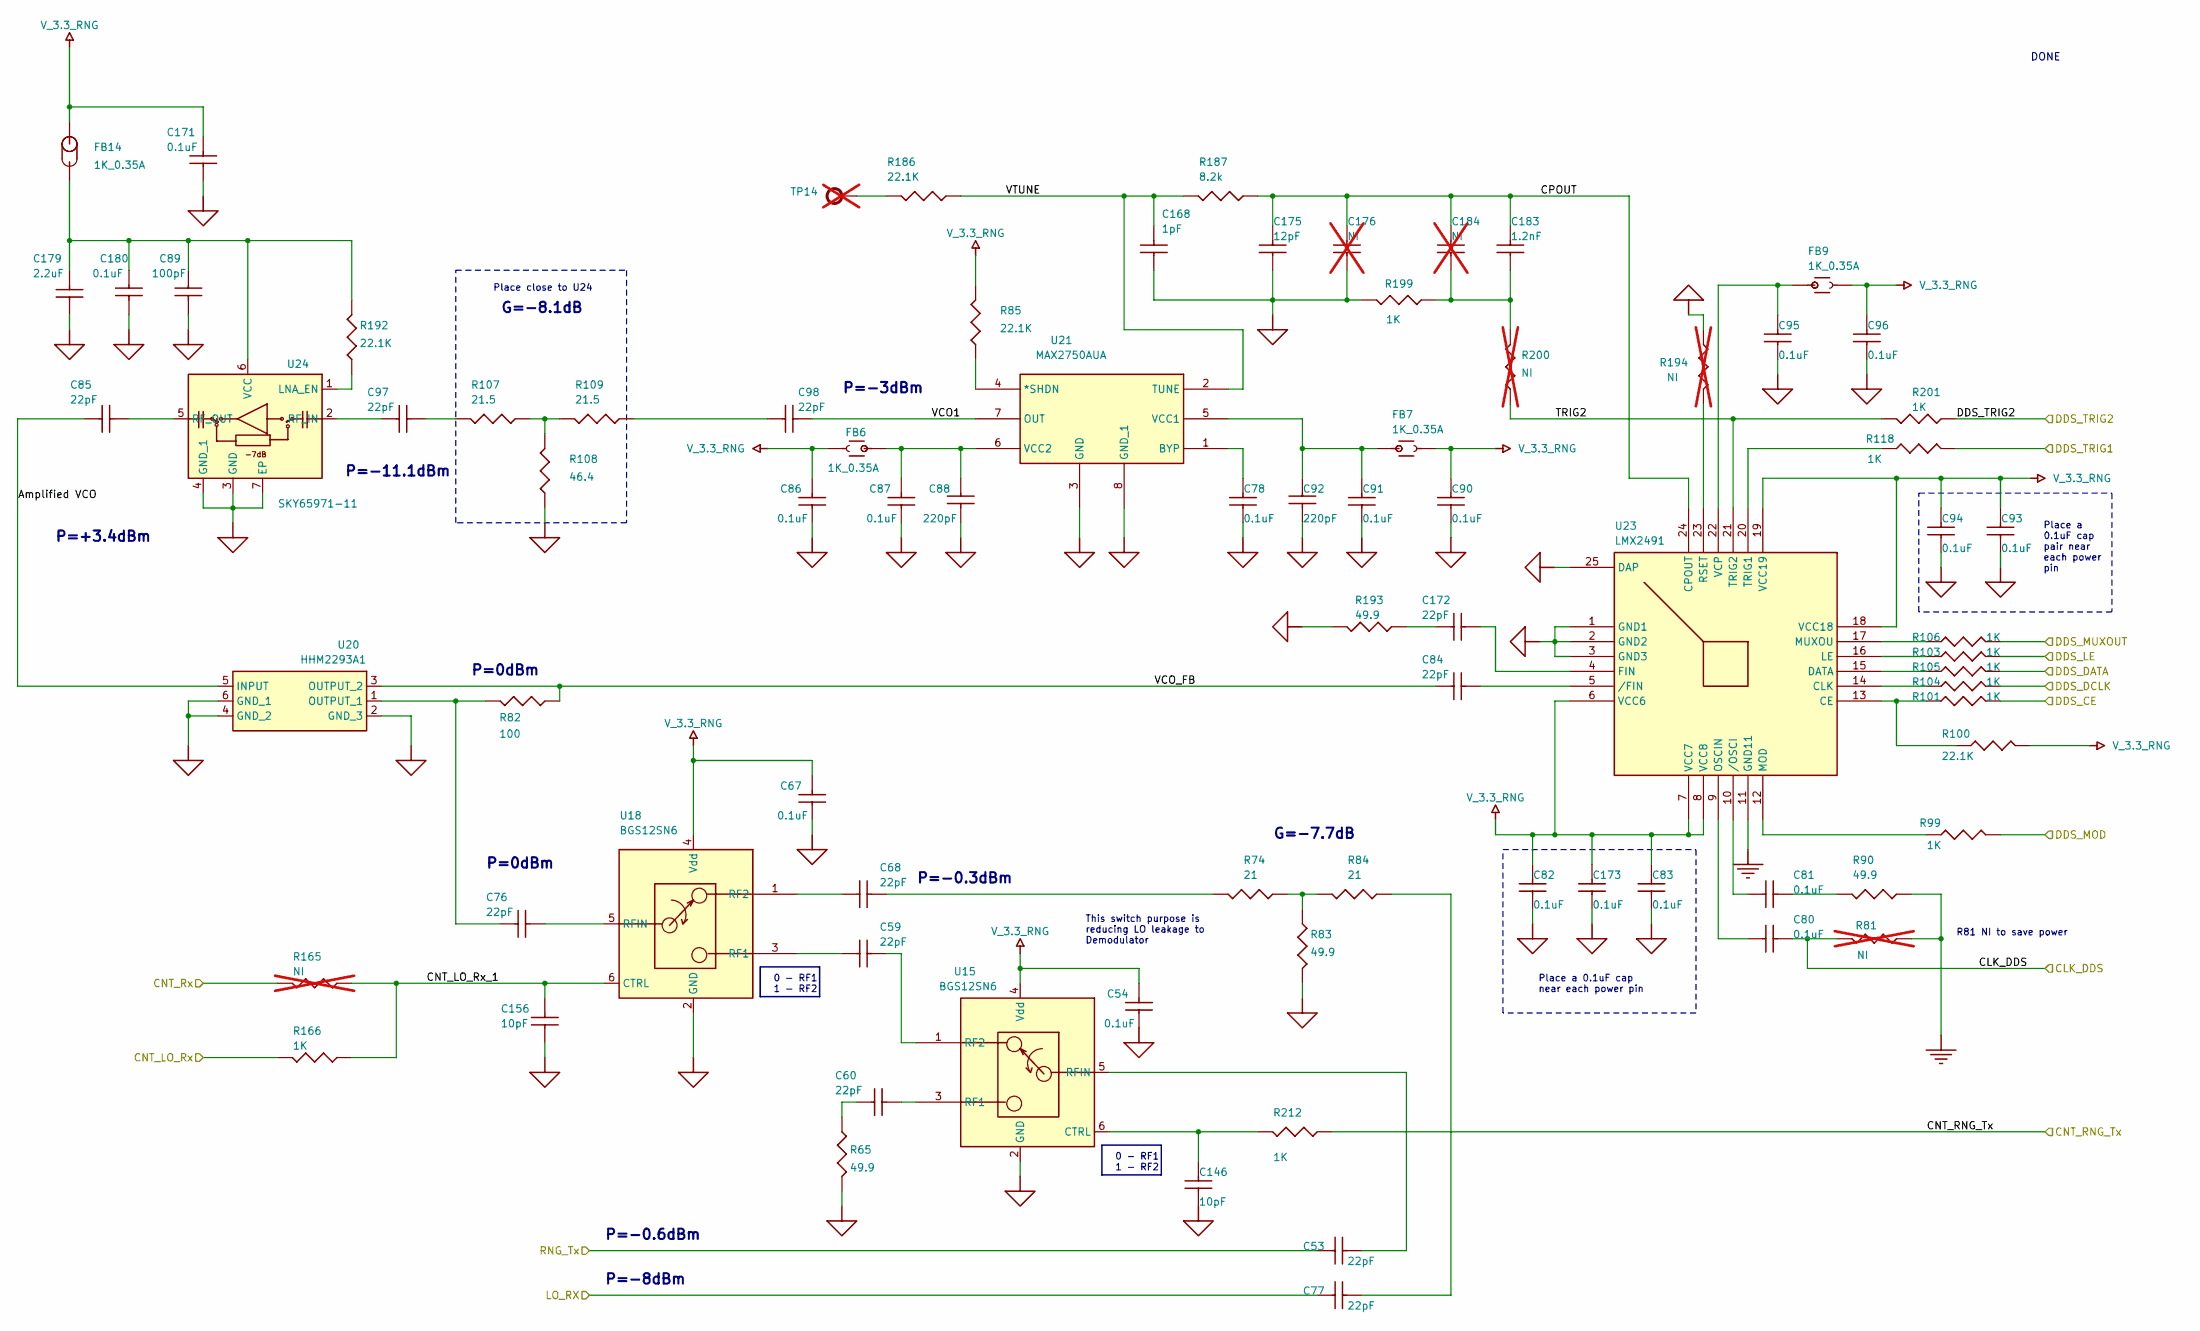
[picture p6: schematic TL_local_oscillator.kicad_sch]

Parts:
C53, C59, C60, C68, C76, C77, C84, C85, C97, C98, C172: 22pF; CAP_CHIP_0402_W24L44H24_RFL; MANUFACTURER P/N GCM1555C1H220JA16D
C54, C67, C78, C80, C81, C82, C83, C86, C87, C90, C91, C93, C94, C95, C96, C171, C173, C180: 0.1uF; CAP_CHIP_0402_W24L44H24_RFL; MANUFACTURER P/N CL05B104KO5NFNC
C88, C92: 220pF; CAP_CHIP_0402_W24L44H24_RFL; MANUFACTURER P/N 0402N221J250CT
C89: 100pF; CAP_CHIP_0402_W24L44H24_RFL; MANUFACTURER P/N CL05C101JB5NNNC
C146, C156: 10pF; CAP_CHIP_0402_W24L44H24_RFL; MANUFACTURER P/N C0402C100J3GACTU
C168: 1pF; CAP_CHIP_0402_W24L44H24_RFL; MANUFACTURER P/N CC0402BRNPO9BN1R0
C175: 12pF; CAP_CHIP_0402_W24L44H24_RFL; MANUFACTURER P/N CC0402JRNPO9BN120
C176, C184: NI; CAP_CHIP_0402_W24L44H24_RFL; MANUFACTURER P/N DoNotPurchase; not fitted
C179: 2.2uF; CAP_CHIP_0402_W24L44H24_RFL; MANUFACTURER P/N LMK105BJ225MV-F
C183: 1.2nF; CAP_CHIP_0402_W24L44H24_RFL; MANUFACTURER P/N CC0402JRX7R9BB122
FB6, FB7, FB9, FB14: 1K_0.35A; CAP_CHIP_0402_W24L44H24_RFL; MANUFACTURER P/N BLM15AX102SN1D
R65, R83, R90, R193: 49.9; CAP_CHIP_0402_W24L44H24_RFL; MANUFACTURER P/N RC0402FR-0749R9L
R74, R84: 21; CAP_CHIP_0402_W24L44H24_RFL; MANUFACTURER P/N RC0402FR-0721RL
R81, R165, R194, R200: NI; CAP_CHIP_0402_W24L44H24_RFL; MANUFACTURER P/N DoNotPurchase; not fitted
R82: 100; CAP_CHIP_0402_W24L44H24_RFL; MANUFACTURER P/N RMCF0402FT100R
R85, R100, R186, R192: 22.1K; CAP_CHIP_0402_W24L44H24_RFL; MANUFACTURER P/N RMCF0402FT22K1
R99, R101, R103, R104, R105, R106, R118, R166, R199, R201, R212: 1K; CAP_CHIP_0402_W24L44H24_RFL; MANUFACTURER P/N RC0402FR-071KL
R107, R109: 21.5; CAP_CHIP_0402_W24L44H24_RFL; MANUFACTURER P/N RC0402FR-0721R5L
R108: 46.4; CAP_CHIP_0402_W24L44H24_RFL; MANUFACTURER P/N RC0402FR-0746R4L
R187: 8.2k; CAP_CHIP_0402_W24L44H24_RFL; MANUFACTURER P/N RC0402FR-078K2L
TP14: TEST POINT; HEADER_0_0_W80L80_0.7_M_1PIN; MANUFACTURER P/N DoNotPurchase; not fitted
U15, U18: BGS12SN6; IC_BGA_0.4_W0.7L1.1H0.4_6PIN; MANUFACTURER P/N BGS12WN6E6327XTSA1
U20: HHM2293A1; IC_0.55_W1.7L0.90H0.7_6PIN; MANUFACTURER P/N HHM2293A1
U21: MAX2750AUA; IC SO 0.65 3.1X3.1 8PIN; MANUFACTURER P/N MAX2750AUA+T
U23: LMX2491; IC_QFN_0.5_W4.1L4.1H0.8_25PIN; MANUFACTURER P/N LMX2491RTWR
U24: SKY65971-11; IC_QFN_W1.5L1.5H0.50_6PIN; MANUFACTURER P/N SKY65971-11

Connections:
Amplified VCO: C85.1, U20.5 (INPUT)
CLK_DDS: C80.2, R81.2
CNT_LO_Rx: R166.1
CNT_LO_Rx_1: C156.2, R165.1, R166.2, U18.6 (CTRL)
CNT_RNG_Tx: R212.2
CNT_Rx: R165.2
CPOUT: C175.2, C176.2, C183.2, C184.2, R187.1, U23.24 (CPOUT)
DDS_CE: R101.2
DDS_DATA: R105.2
DDS_DCLK: R104.2
DDS_LE: R103.2
DDS_MOD: R99.2
DDS_MUXOUT: R106.2
DDS_TRIG1: R118.2
DDS_TRIG2: R201.1
GND: R81.1, R90.1, U23.11 (GND11)
GND_SIGNAL: C54.1, C67.1, C78.1, C82.1, C83.1, C86.1, C87.1, C88.2, C89.2, C90.1, C91.1, C92.2, C93.1, C94.1, C95.1, C96.1, C146.1, C156.1, C168.1, C171.1, C173.1, C175.1, C176.1, C179.1, C180.2, R65.2, R83.1, R108.2, R193.2, R194.1, R199.2, U15.2 (GND), U18.2 (GND), U20.2 (GND_3), U20.4 (GND_2), U20.6 (GND_1), U21.3 (GND), U21.8 (GND_1), U23.1 (GND1), U23.2 (GND2), U23.3 (GND3), U23.25 (DAP), U24.3 (GND), U24.4 (GND_1), U24.7 (EP)
LO_RX: C77.1
unnamed: C53.2, U15.5 (RFIN)
unnamed: C59.1, U18.3 (RF1)
unnamed: C59.2, U15.1 (RF2)
unnamed: C60.1, R65.1
unnamed: C60.2, U15.3 (RF1)
unnamed: C68.1, U18.1 (RF2)
unnamed: C68.2, R74.1
unnamed: C76.1, R82.2, U20.1 (OUTPUT_1)
unnamed: C76.2, U18.5 (RFIN)
unnamed: C77.2, R84.2
unnamed: C78.2, U21.1 (BYP)
unnamed: C80.1, U23.9 (OSCIN)
unnamed: C81.1, U23.10 (/OSCI)
unnamed: C81.2, R90.2
unnamed: C84.2, U23.5 (/FIN)
unnamed: C85.2, U24.5 (RF_OUT)
unnamed: C87.2, C88.1, FB6.1, U21.6 (VCC2)
unnamed: C91.2, C92.1, FB7.1, U21.5 (VCC1)
unnamed: C95.2, FB9.1, U23.22 (VCP)
unnamed: C97.1, U24.2 (RF_IN)
unnamed: C97.2, R107.1
unnamed: C98.1, R109.2
unnamed: C146.2, R212.1, U15.6 (CTRL)
unnamed: C172.1, R193.1
unnamed: C172.2, U23.4 (FIN)
unnamed: C89.1, C179.2, C180.1, FB14.2, R192.2, U24.6 (VCC)
unnamed: C183.1, C184.1, R199.1, R200.2
unnamed: R74.2, R83.2, R84.1
unnamed: R85.1, U21.4 (*SHDN)
unnamed: R99.1, U23.12 (MOD)
unnamed: R100.2, R101.1, U23.13 (CE)
unnamed: R103.1, U23.16 (LE)
unnamed: R104.1, U23.14 (CLK)
unnamed: R105.1, U23.15 (DATA)
unnamed: R106.1, U23.17 (MUXOU)
unnamed: R107.2, R108.1, R109.1
unnamed: R118.1, U23.20 (TRIG1)
unnamed: R186.1, TP14.1
unnamed: R192.1, U24.1 (LNA_EN)
unnamed: R194.2, U23.23 (RSET)
RNG_Tx: C53.1
TRIG2: R200.1, R201.2, U23.21 (TRIG2)
VCO1: C98.2, U21.7 (OUT)
VCO_FB: C84.1, R82.1, U20.3 (OUTPUT_2)
VTUNE: C168.2, R186.2, R187.2, U21.2 (TUNE)
V_3.3_RNG: C54.2, C67.2, C82.2, C83.2, C86.2, C90.2, C93.2, C94.2, C96.2, C171.2, C173.2, FB6.2, FB7.2, FB9.2, FB14.1, R85.2, R100.1, U15.4 (Vdd), U18.4 (Vdd), U23.6 (VCC6), U23.7 (VCC7), U23.8 (VCC8), U23.18 (VCC18), U23.19 (VCC19)

Notes on the sheet:
This switch purpose is reducing LO leakage to Demodulator
0 - RF1 1 - RF2
Place a 0.1uF cap pair near each power pin
Place a 0.1uF cap near each power pin
Place close to U24
R81 NI to save power
P=-11.1dBm
G=-8.1dB
P=0dBm
P=+3.4dBm
G=-7.7dB
P=-8dBm
P=-0.6dBm
P=-0.3dBm
P=-3dBm
DONE
