szohar/TrueLocation_lay/TruelocationRev3.0/TL_peripherals.kicad_sch

## KiCad design TruelocationRev3.0/TL_peripherals.kicad_sch (2025-07-09)

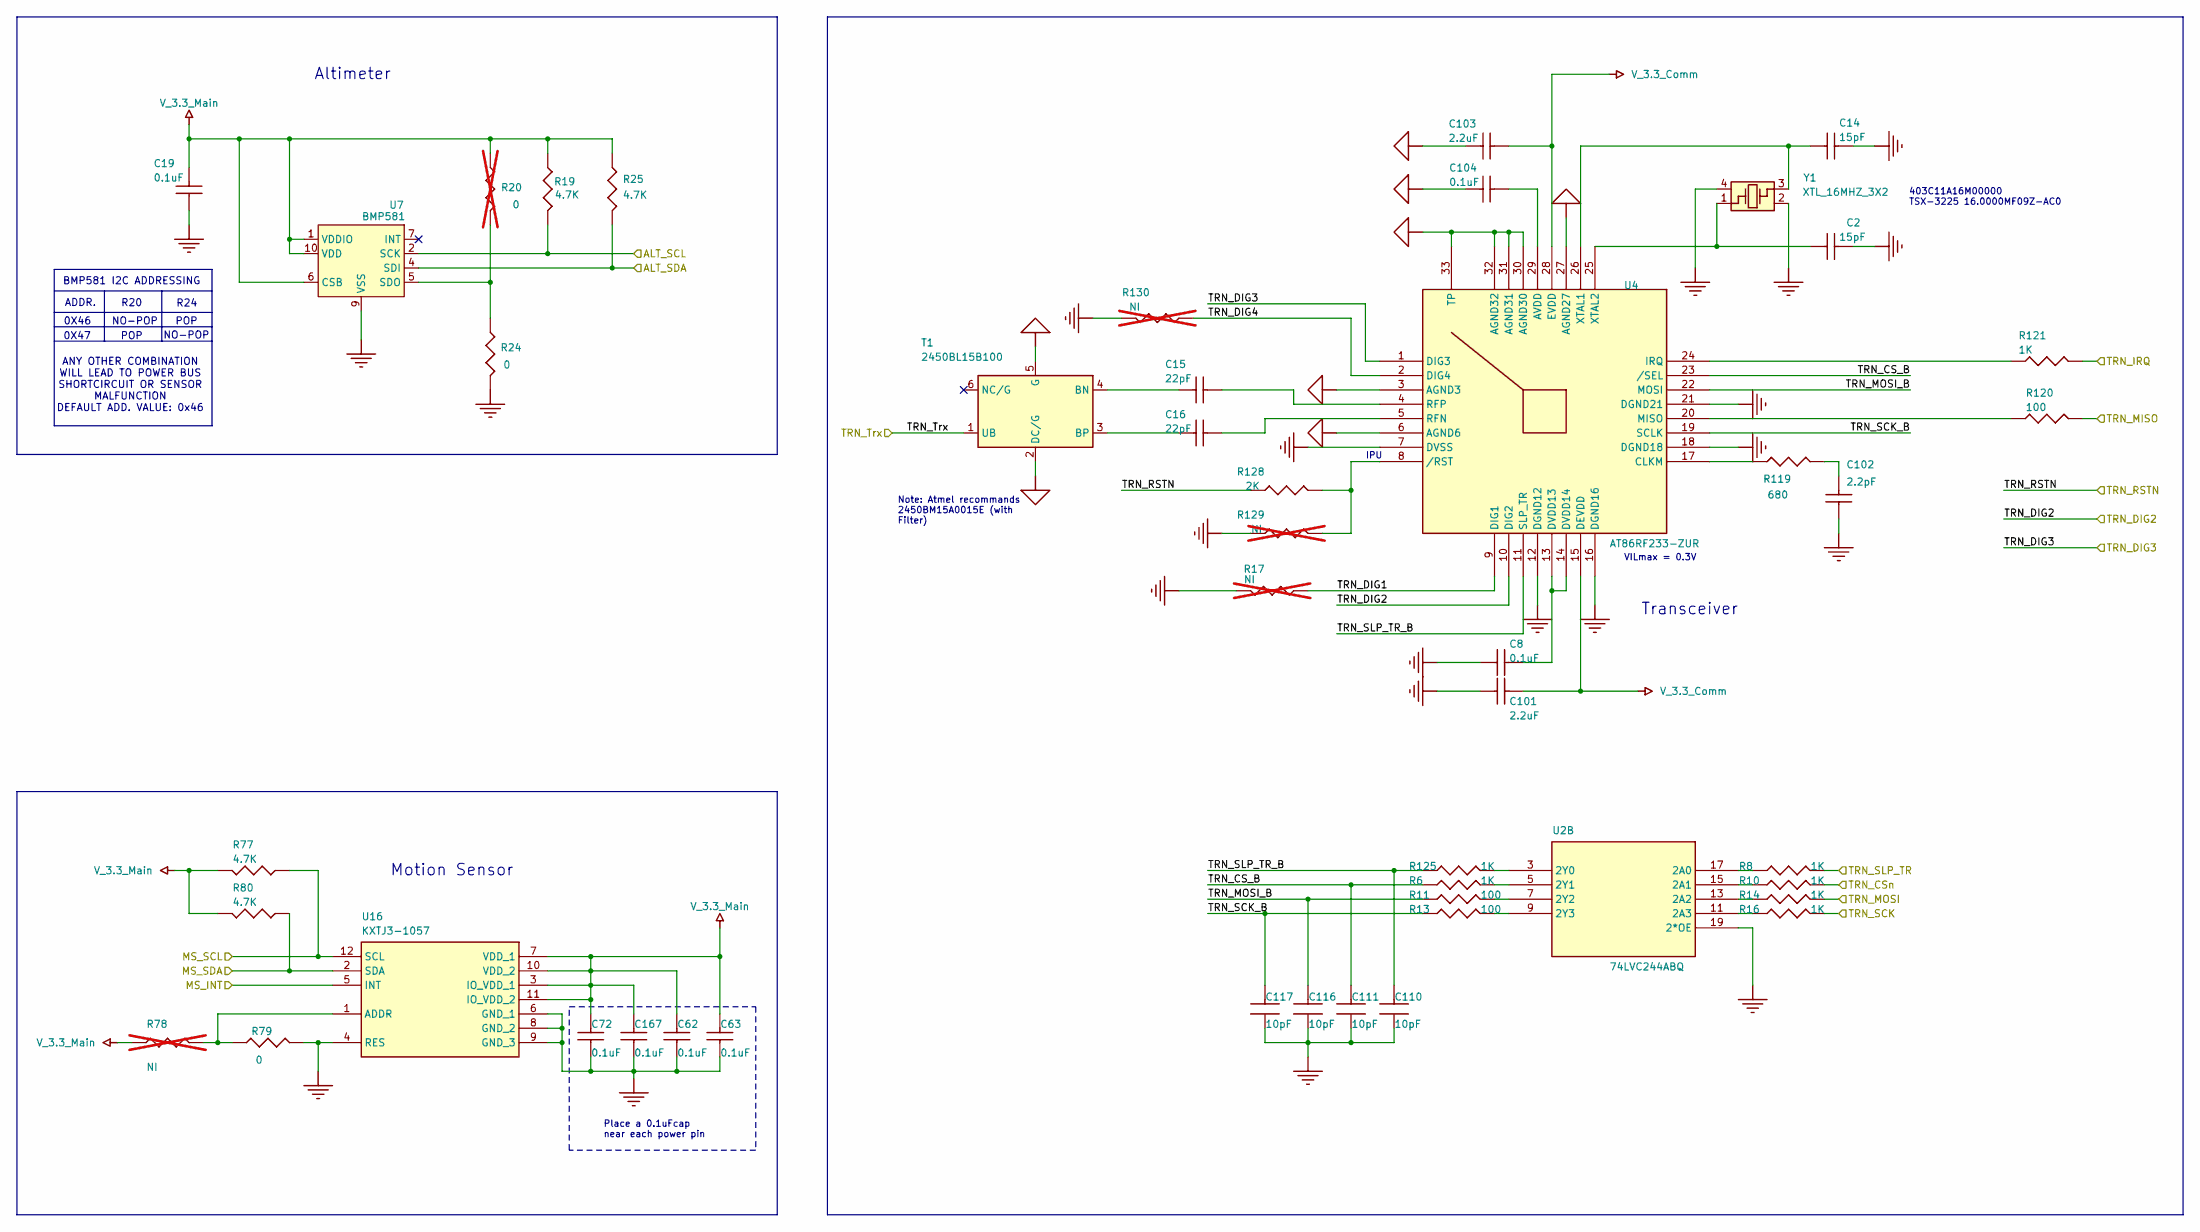
[picture p7: schematic TL_peripherals.kicad_sch]

Parts:
C2, C14: 15pF; CAP_CHIP_0402_W24L44H24_RFL; MANUFACTURER P/N C0402C150J4GACTU
C8, C19, C62, C63, C72, C104, C167: 0.1uF; CAP_CHIP_0402_W24L44H24_RFL; MANUFACTURER P/N CL05B104KO5NFNC
C15, C16: 22pF; CAP_CHIP_0402_W24L44H24_RFL; MANUFACTURER P/N GCM1555C1H220JA16D
C101, C103: 2.2uF; CAP_CHIP_0402_W24L44H24_RFL; MANUFACTURER P/N LMK105BJ225MV-F
C102: 2.2pF; CAP_CHIP_0402_W24L44H24_RFL; MANUFACTURER P/N CC0402BRNPO9BN2R2
C110, C111, C116, C117: 10pF; CAP_CHIP_0402_W24L44H24_RFL; MANUFACTURER P/N C0402C100J3GACTU
R6, R8, R10, R14, R16, R121, R125: 1K; CAP_CHIP_0402_W24L44H24_RFL; MANUFACTURER P/N RC0402FR-071KL
R11, R13, R120: 100; CAP_CHIP_0402_W24L44H24_RFL; MANUFACTURER P/N RMCF0402FT100R
R17, R78, R129, R130: NI; CAP_CHIP_0402_W24L44H24_RFL; MANUFACTURER P/N DoNotPurchase; not fitted
R19, R25, R77, R80: 4.7K; CAP_CHIP_0402_W24L44H24_RFL; MANUFACTURER P/N RMCF0402FT4K70
R20: 0; CAP_CHIP_0402_W24L44H24_RFL; MANUFACTURER P/N CRG0402ZR; not fitted
R24, R79: 0; CAP_CHIP_0402_W24L44H24_RFL; MANUFACTURER P/N CRG0402ZR
R119: 680; CAP_CHIP_0402_W24L44H24_RFL; MANUFACTURER P/N RC0402FR-07680RL
R128: 2K; CAP_CHIP_0402_W24L44H24_RFL; MANUFACTURER P/N RMCF0402FT2K00
T1: 2450BL15B100; COIL_MOLD_2.1x1.35_6PIN; MANUFACTURER P/N 2450BL15B0100001E
U2: 74LVC244ABQ; IC_QFN_W4.6L2.6H1_21PIN; MANUFACTURER P/N 74LVC244ABQ,115
U4: AT86RF233-ZUR; IC_QFN_0.5_W5.1L5.1H0.9_32PIN_KO; MANUFACTURER P/N AT86RF233-ZUR
U7: BMP581; BMP581-10WFLGA; MANUFACTURER P/N BMP-581
U16: KXTJ3-1057; IC_QFN_0.5W2.05L2.05H1_12PIN; MANUFACTURER P/N KXTJ3-1057
Y1: XTL_16MHZ_3X2; XTAL_CHIP_W3.35L2.65H20.6_4PIN; MANUFACTURER P/N TSX-3225 16.0000MF09Z-AC0

Connections:
ALT_SCL: R19.2, U7.2 (SCK)
ALT_SDA: R25.2, U7.4 (SDI)
GND: C2.2, C8.1, C14.2, C19.1, C62.1, C63.1, C72.1, C101.1, C102.1, C110.1, C111.1, C116.1, C117.1, C167.1, R17.2, R24.2, R79.2, R129.2, R130.2, U2.19 (2*OE), U4.7 (DVSS), U4.12 (DGND12), U4.16 (DGND16), U4.18 (DGND18), U4.21 (DGND21), U7.3 (VSS), U7.8 (VSS), U7.9 (VSS), U16.4 (RES), U16.6 (GND_1), U16.8 (GND_2), U16.9 (GND_3), Y1.2, Y1.4
GND_SIGNAL: C103.1, C104.1, T1.2 (DC/G), T1.5 (G), U4.3 (AGND3), U4.6 (AGND6), U4.27 (AGND27), U4.30 (AGND30), U4.31 (AGND31), U4.32 (AGND32), U4.33 (TP)
MS_INT: U16.5 (INT)
MS_SCL: R77.2, U16.12 (SCL)
MS_SDA: R80.2, U16.2 (SDA)
unnamed: C2.1, U4.25 (XTAL2), Y1.1
unnamed: C8.2, U4.13 (DVDD13), U4.14 (DVDD14)
unnamed: C14.1, U4.26 (XTAL1), Y1.3
unnamed: C15.1, T1.4 (BN)
unnamed: C15.2, U4.4 (RFP)
unnamed: C16.1, T1.3 (BP)
unnamed: C16.2, U4.5 (RFN)
unnamed: C102.2, R119.2
unnamed: C104.2, U4.29 (AVDD)
unnamed: R6.2, U2.5 (2Y1)
unnamed: R8.1, U2.17 (2A0)
unnamed: R10.1, U2.15 (2A1)
unnamed: R11.2, U2.7 (2Y2)
unnamed: R13.2, U2.9 (2Y3)
unnamed: R14.1, U2.13 (2A2)
unnamed: R16.1, U2.11 (2A3)
unnamed: R20.2, R24.1, U7.5 (SDO)
unnamed: R78.2, R79.1, U16.1 (ADDR)
unnamed: R119.1, U4.17 (CLKM)
unnamed: R120.1, U4.20 (MISO)
unnamed: R121.1, U4.24 (IRQ)
unnamed: R125.2, U2.3 (2Y0)
unnamed: R128.2, R129.1, U4.8 (/RST)
TRN_CS_B: C111.2, R6.1, U4.23 (/SEL)
TRN_CSn: R10.2
TRN_DIG1: R17.1, U4.9 (DIG1)
TRN_DIG2: U4.10 (DIG2)
TRN_DIG3: U4.1 (DIG3)
TRN_DIG4: R130.1, U4.2 (DIG4)
TRN_IRQ: R121.2
TRN_MISO: R120.2
TRN_MOSI: R14.2
TRN_MOSI_B: C116.2, R11.1, U4.22 (MOSI)
TRN_RSTN: R128.1
TRN_SCK: R16.2
TRN_SCK_B: C117.2, R13.1, U4.19 (SCLK)
TRN_SLP_TR: R8.2
TRN_SLP_TR_B: C110.2, R125.1, U4.11 (SLP_TR)
TRN_Trx: T1.1 (UB)
V_3.3_Comm: C101.2, C103.2, U4.15 (DEVDD), U4.28 (EVDD)
V_3.3_Main: C19.2, C62.2, C63.2, C72.2, C167.2, R19.1, R20.1, R25.1, R77.1, R78.1, R80.1, U7.1 (VDDIO), U7.6 (CSB), U7.10 (VDD), U16.3 (IO_VDD_1), U16.7 (VDD_1), U16.10 (VDD_2), U16.11 (IO_VDD_2)

Notes on the sheet:
Note: Atmel recommands 2450BM15A0015E (with Filter)
403C11A16M00000 TSX-3225 16.0000MF09Z-AC0
Place a 0.1uFcap near each power pin
ANY OTHER COMBINATION WILL LEAD TO POWER BUS SHORTCIRCUIT OR SENSOR MALFUNCTION DEFAULT ADD. VALUE: 0x46
R24
NO-POP
0X46
POP
Motion Sensor
Transceiver
IPU
R20
VILmax = 0.3V
ADDR.
Altimeter
0X47
BMP581 I2C ADDRESSING
