szohar/TrueLocation_lay/TruelocationRev3.0/TL_power.kicad_sch

## KiCad design TruelocationRev3.0/TL_power.kicad_sch (2025-07-09)

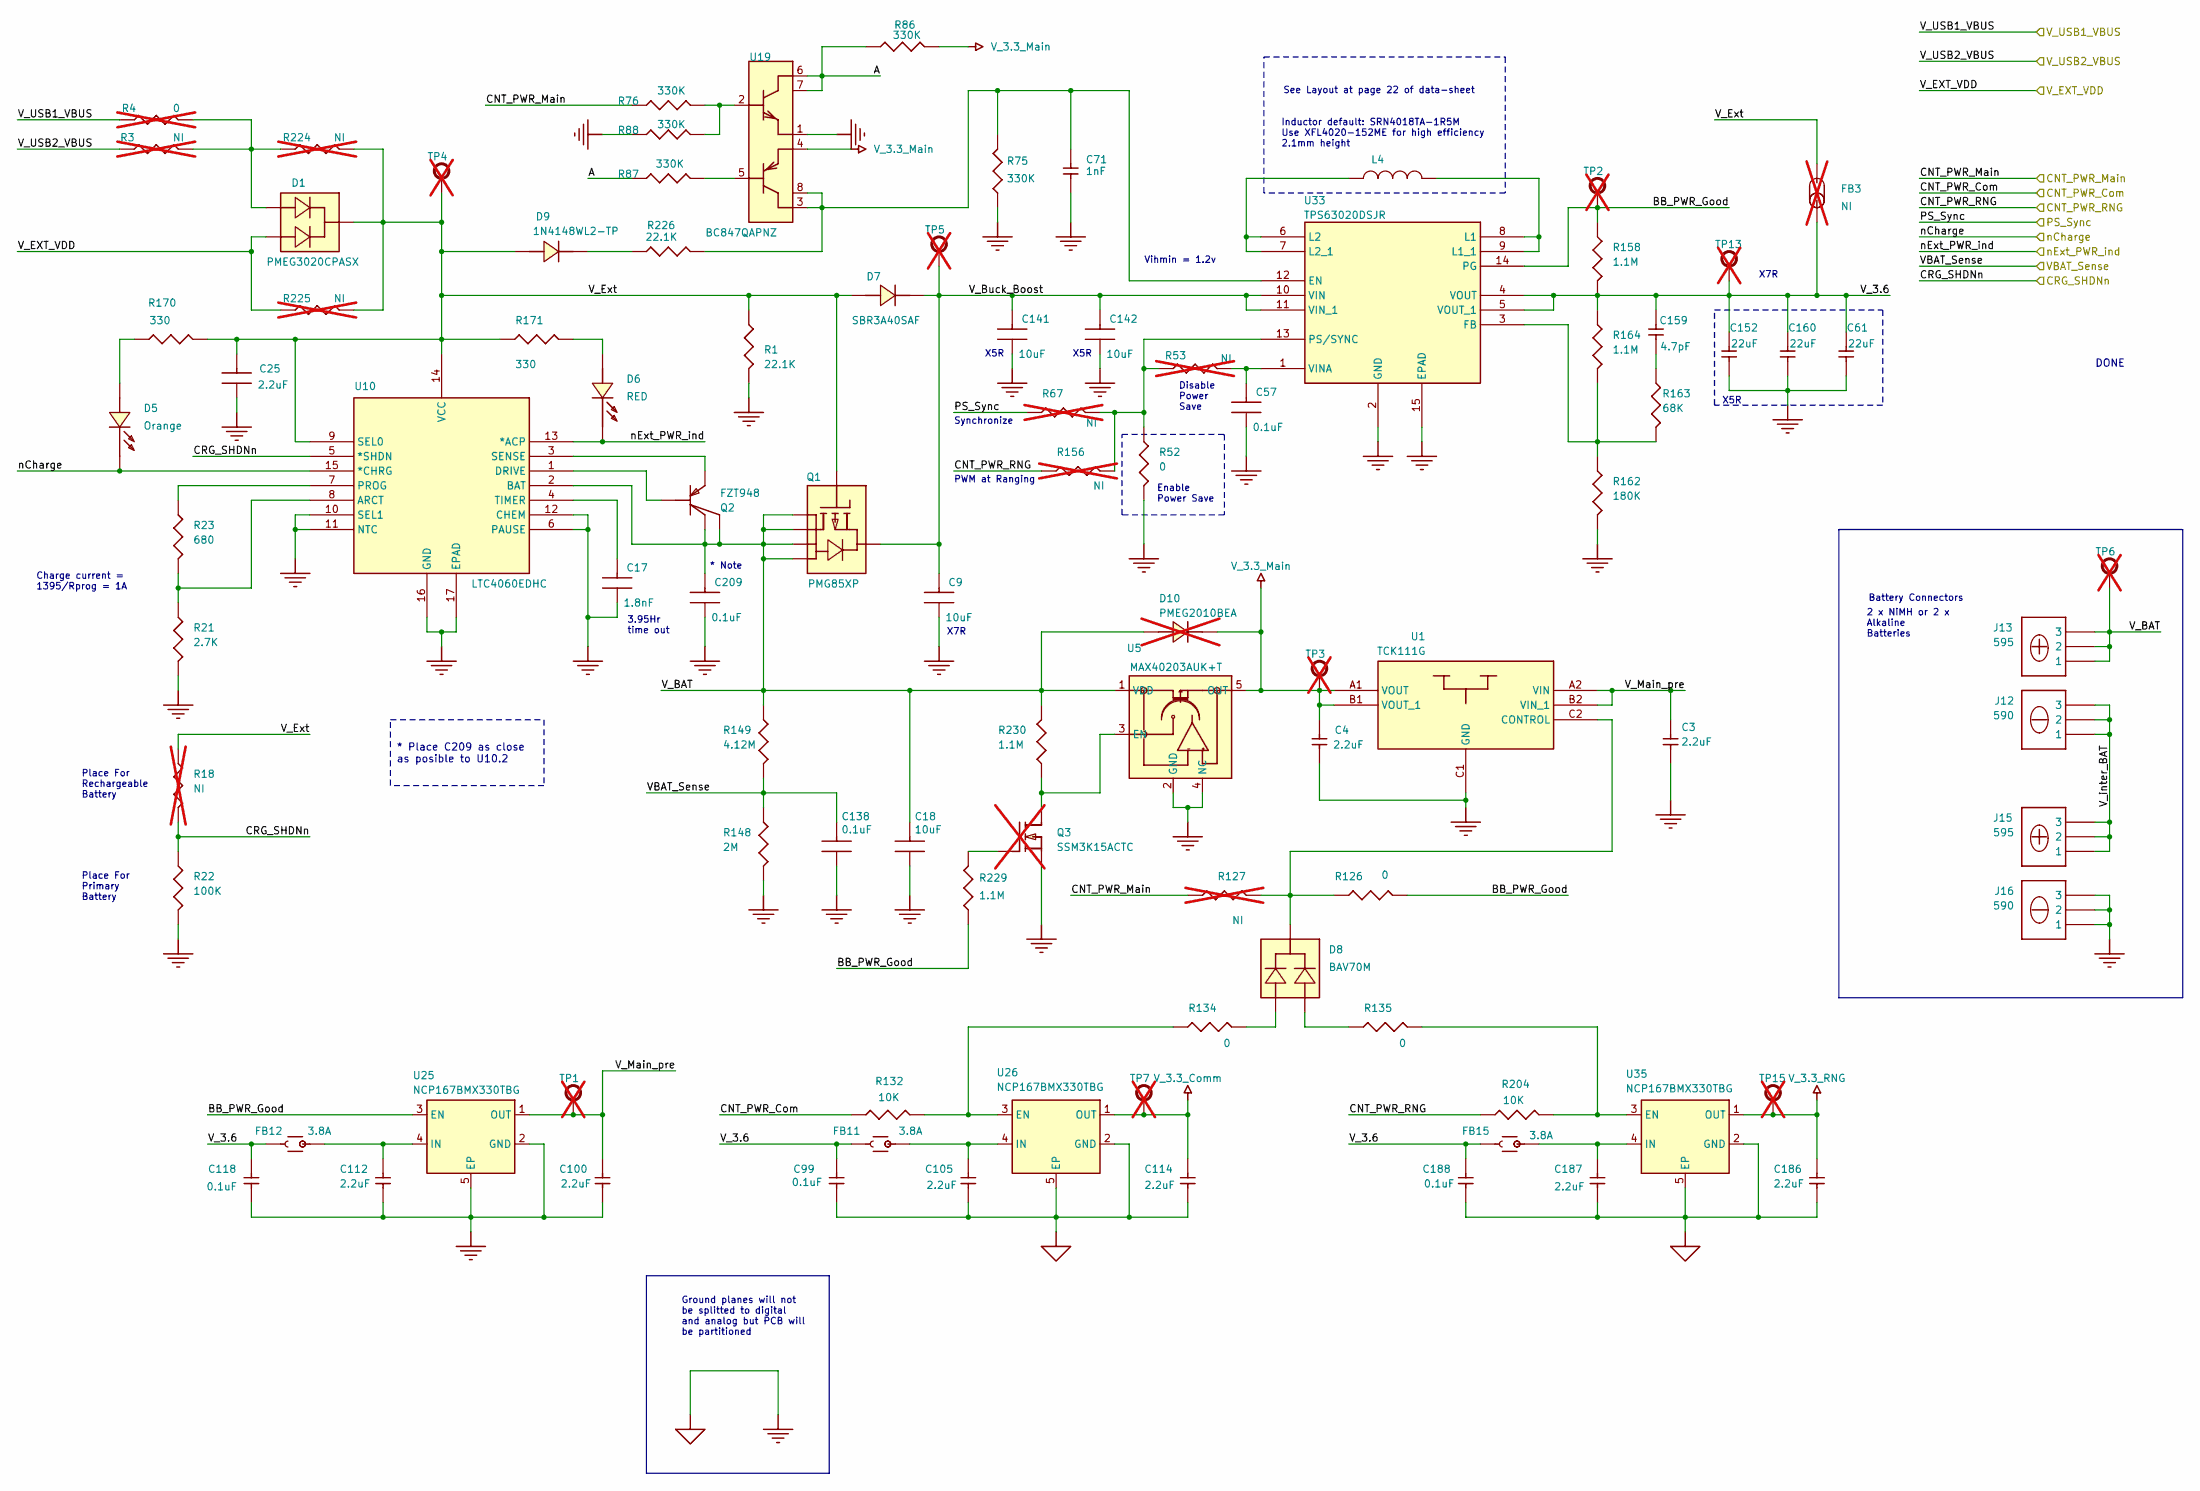
[picture p8: schematic TL_power.kicad_sch]

Parts:
C3, C4, C25, C100, C105, C112, C114, C186, C187: 2.2uF; CAP_CHIP_0402_W24L44H24_RFL; MANUFACTURER P/N LMK105BJ225MV-F
C9: 10uF; CAP_CHIP_0603; MANUFACTURER P/N GRM188R61E106KA73J
C17: 1.8nF; CAP_CHIP_0402_W24L44H24_RFL; MANUFACTURER P/N CC0402JRX7R9BB182
C18, C141, C142: 10uF; CAP_CHIP_0603_W40L70H22_RFL; MANUFACTURER P/N GRM188R61E106KA73J
C57, C99, C118, C138, C188: 0.1uF; CAP_CHIP_0402_W24L44H24_RFL; MANUFACTURER P/N CL05B104KO5NFNC
C61, C152, C160: 22uF; CAP_CHIP_0603; MANUFACTURER P/N GRM188R60J226MEA0J
C71: 1nF; CAP_CHIP_0402_W24L44H24_RFL; MANUFACTURER P/N CC0402KRX7R7BB102
C159: 4.7pF; CAP_CHIP_0402_W24L44H24_RFL; MANUFACTURER P/N CC0402BRNPO9BN4R7
C209: 0.1uF; CAP_CHIP_0402; MANUFACTURER P/N CL05B104KO5NFNC
D1: PMEG3020CPASX; DIODE_SOT1061D_3PIN; MANUFACTURER P/N PMEG3020CPASX
D5: Orange; LED_CHIP_0402_W24L44H28; MANUFACTURER P/N SML-P12DTT86R
D6: RED; LED_CHIP_0402_W24L44H28; MANUFACTURER P/N SML-P12VTT86R
D7: SBR3A40SAF; DIODE_DO-214AC; MANUFACTURER P/N SBR3A40SAF-13
D8: BAV70M; DIODE_SOT883_3PIN; MANUFACTURER P/N BAV70M,315
D9: 1N4148WL2-TP; DIODE_DFN1006 2PIN; MANUFACTURER P/N 1N4148WL2-TP
D10: PMEG2010BEA; DIODE_SOD-323; MANUFACTURER P/N PMEG2010BEA,115; not fitted
FB3: NI; CAP_CHIP_0402_W24L44H24_RFL; MANUFACTURER P/N DoNotPurchase; not fitted
FB11, FB12, FB15: 3.8A; CAP_CHIP_0402_W24L44H24_RFL; MANUFACTURER P/N BLM15KD200SN1D
J12, J16: 590; CON 628 3PIN; MANUFACTURER P/N 628
J13, J15: 595; CON 595 3PIN; MANUFACTURER P/N 595
L4: 1.5uH; COIL_MOLD_W4.2L4.2H1.88_2PIN; MANUFACTURER P/N SRN4018TA-1R5M
Q1: PMG85XP; IC_DCK_W2.15L1.40H1.10_6PIN; MANUFACTURER P/N PMG85XP,115
Q2: FZT948; IC_SOT-223_4PIN; MANUFACTURER P/N FZT948TA
Q3: SSM3K15ACTC; TRANS_C3T3C_0.8X0.6 3PIN; MANUFACTURER P/N SSM3K15ACTC,L3F; not fitted
R1, R226: 22.1K; CAP_CHIP_0402_W24L44H24_RFL; MANUFACTURER P/N RMCF0402FT22K1
R3, R18, R53, R67, R127, R156: NI; CAP_CHIP_0402_W24L44H24_RFL; MANUFACTURER P/N DoNotPurchase; not fitted
R4: 0; CAP_CHIP_0402_W24L44H24_RFL; MANUFACTURER P/N CRG0402ZR; not fitted
R21: 2.7K; CAP_CHIP_0402_W24L44H24_RFL; MANUFACTURER P/N RMCF0402FT2K70
R22: 100K; CAP_CHIP_0402_W24L44H24_RFL; MANUFACTURER P/N RMCF0402FT100K
R23: 680; CAP_CHIP_0402_W24L44H24_RFL; MANUFACTURER P/N RC0402FR-07680RL
R52, R126, R134, R135: 0; CAP_CHIP_0402_W24L44H24_RFL; MANUFACTURER P/N CRG0402ZR
R75, R76, R86, R87, R88: 330K; CAP_CHIP_0402_W24L44H24_RFL; MANUFACTURER P/N RC0402JR-07330KL
R132, R204: 10K; CAP_CHIP_0402_W24L44H24_RFL; MANUFACTURER P/N RMCF0402FT10K0
R148: 2M; CAP_CHIP_0402_W24L44H24_RFL; MANUFACTURER P/N RMCF0402FT2M00
R149: 4.12M; CAP_CHIP_0402_W24L44H24_RFL; MANUFACTURER P/N CRCW04024M12FKED
R158, R164, R229, R230: 1.1M; CAP_CHIP_0402_W24L44H24_RFL; MANUFACTURER P/N RMCF0402FT1M10
R162: 180K; CAP_CHIP_0402_W24L44H24_RFL; MANUFACTURER P/N RC0402JR-07180KL
R163: 68K; CAP_CHIP_0402_W24L44H24_RFL; MANUFACTURER P/N RC0402JR-0768KL
R170, R171: 330; CAP_CHIP_0402_W24L44H24_RFL; MANUFACTURER P/N RC0402JR-07330RL
R224, R225: NI; CAP_CHIP_0402; MANUFACTURER P/N DoNotPurchase; not fitted
TP1, TP2, TP3, TP4, TP5, TP6, TP7, TP13, TP15: TEST POINT; HEADER_0_0_W80L80_0.7_M_1PIN; MANUFACTURER P/N DoNotPurchase; not fitted
U1: TCK111G; IC_0.5_W1L1.5H0.54_6PIN; MANUFACTURER P/N TCK111G,LF
U5: MAX40203AUK+T; IC_SOT-23_5OF6PIN; MANUFACTURER P/N MAX40203AUK+T
U10: LTC4060EDHC; IC_MLF_0.5_W3L5H1.0_16PIN; MANUFACTURER P/N LTC4060EDHC
U19: BC847QAPNZ; IC_0.35_W1.15L1.05H0.40_8PIN; MANUFACTURER P/N BC847QAPNZ
U25, U26, U35: NCP167BMX330TBG; IC _DFN_W1L 1H0.43_ 5PIN; MANUFACTURER P/N NCP167BMX330TBG
U33: TPS63020DSJR; IC_QFN_W4.15L3.15H1_15PIN; MANUFACTURER P/N TPS63020DSJR

Connections:
A: R86.1, R87.1, U19.6 (c1), U19.7 (c11)
BB_PWR_Good: R126.2, R158.1, R229.1, TP2.1, U25.3 (EN), U33.14 (PG)
CNT_PWR_Com: R132.1
CNT_PWR_Main: R76.1, R127.1
CNT_PWR_RNG: R156.1, R204.1
CRG_SHDNn: R18.2, R22.1, U10.5 (*SHDN)
GND: C3.1, C4.1, C9.1, C17.1, C18.1, C25.1, C57.1, C61.2, C71.1, C99.1, C100.1, C105.1, C112.1, C114.1, C118.1, C138.1, C141.1, C142.1, C152.2, C160.2, C186.1, C187.1, C188.1, C209.1, J16.1, J16.2, J16.3, Q3.2 (S), R1.1, R21.2, R22.2, R52.2, R75.1, R88.1, R148.2, R162.2, U1.C1 (GND), U5.2 (GND), U5.4 (NC), U10.6 (PAUSE), U10.10 (SEL1), U10.11 (NTC), U10.12 (CHEM), U10.16 (GND), U10.17 (EPAD), U19.1 (e1), U25.2 (GND), U25.5 (EP), U26.2 (GND), U26.5 (EP), U33.2 (GND), U33.15 (EPAD), U35.2 (GND), U35.5 (EP)
unnamed: C17.2, U10.4 (TIMER)
unnamed: C57.2, R53.2, U33.1 (VINA)
unnamed: C71.2, R75.2, R226.1, U19.3 (c2), U19.8 (c22), U33.12 (EN)
unnamed: C105.2, FB11.1, U26.4 (IN)
unnamed: C112.2, FB12.1, U25.4 (IN)
unnamed: C159.2, R163.1
unnamed: C187.2, FB15.1, U35.4 (IN)
unnamed: D1.1, R3.2, R4.2, R224.1
unnamed: D5.2 (ANODE), R170.1
unnamed: D6.2 (ANODE), R171.2
unnamed: D8.1, R134.2
unnamed: D8.2, R135.1
unnamed: D8.3, R126.1, R127.2, U1.C2 (CONTROL)
unnamed: D9.1 (K), R226.2
unnamed: L4.1, U33.6 (L2), U33.7 (L2_1)
unnamed: L4.2, U33.8 (L1), U33.9 (L1_1)
unnamed: Q2.1 (B), U10.1 (DRIVE)
unnamed: Q2.3 (E), U10.3 (SENSE)
unnamed: Q3.1 (G), R229.2
unnamed: Q3.3 (D), R230.1, U5.3 (EN)
unnamed: R21.1, R23.2, U10.8 (ARCT)
unnamed: R23.1, U10.7 (PROG)
unnamed: R76.2, R88.2, U19.2 (b1)
unnamed: R87.2, U19.5 (b2)
unnamed: R132.2, R134.1, U26.3 (EN)
unnamed: R135.2, R204.2, U35.3 (EN)
unnamed: R52.1, R53.1, R67.2, R156.2, U33.13 (PS/SYNC)
unnamed: R162.1, R163.2, R164.2, U33.3 (FB)
PS_Sync: R67.1
VBAT_Sense: C138.2, R148.1, R149.2
V_3.3_Comm: C114.2, TP7.1, U26.1 (OUT)
V_3.3_Main: C4.2, D10.1 (K), R86.2, TP3.1, U1.A1 (VOUT), U1.B1 (VOUT_1), U5.5 (OUT), U19.4 (e2)
V_3.3_RNG: C186.2, TP15.1, U35.1 (OUT)
V_3.6: C61.1, C99.2, C118.2, C152.1, C159.1, C160.1, C188.2, FB3.1, FB11.2, FB12.2, FB15.2, R158.2, R164.1, TP13.1, U33.4 (VOUT), U33.5 (VOUT_1)
V_BAT: C18.2, C209.2, D10.2 (A), J13.1, J13.2, J13.3, Q1.1 (D1), Q1.2 (D2), Q1.5 (D3), Q1.6 (D4), Q2.2 (C), Q2.4 (C1), R149.1, R230.2, TP6.1, U5.1 (VDD), U10.2 (BAT)
V_Buck_Boost: C9.2, C141.2, C142.2, D7.1 (K), Q1.4 (S), TP5.1, U33.10 (VIN), U33.11 (VIN_1)
V_EXT_VDD: D1.2, R225.1
V_Ext: C25.2, D1.3, D7.2 (A), D9.2 (A), FB3.2, Q1.3 (G), R1.2, R18.1, R170.2, R171.1, R224.2, R225.2, TP4.1, U10.9 (SEL0), U10.14 (VCC)
V_Main_pre: C3.2, C100.2, TP1.1, U1.A2 (VIN), U1.B2 (VIN_1), U25.1 (OUT)
V_USB1_VBUS: R4.1
V_USB2_VBUS: R3.1
V_inter_BAT: J12.1, J12.2, J12.3, J15.1, J15.2, J15.3
nCharge: D5.1 (CATHODE), U10.15 (*CHRG)
nExt_PWR_ind: D6.1 (CATHODE), U10.13 (*ACP)

Notes on the sheet:
Enable Power Save
Disable Power Save
3.95Hr time out
Inductor default: SRN4018TA-1R5M Use XFL4020-152ME for high efficiency 2.1mm height
Ground planes will not be splitted to digital and analog but PCB will be partitioned
2 x NiMH or 2 x Alkaline Batteries
Charge current = 1395/Rprog = 1A
Place For Primary Battery
* Place C209 as close as posible to U10.2
Place For Rechargeable Battery
X7R
Battery Connectors
X5R
See Layout at page 22 of data-sheet
* Note
Synchronize
PWM at Ranging
Vihmin = 1.2v
DONE
